starduststorm/motionhexa/case/motionhexa backcase v5-6 - 4.2mm button - 0.5-1mm clip.stl

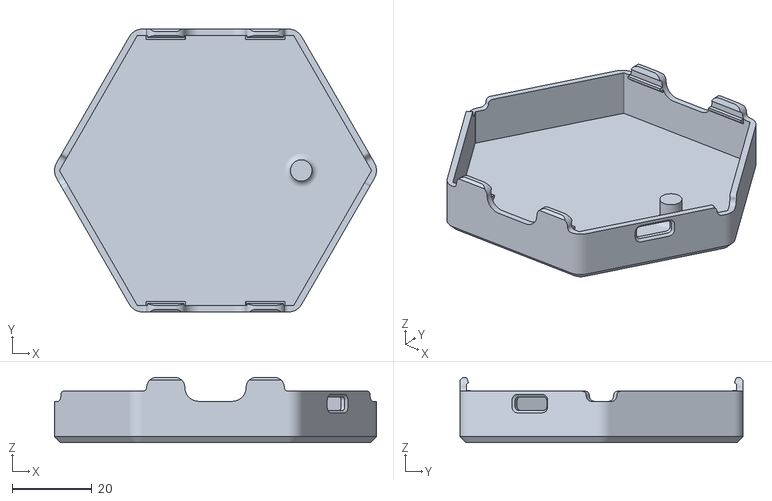
[picture p5: CAD file, 2026-09-29]
case/motionhexa backcase v5-6 - 4.2mm button - 0.5-1mm clip.stl
80.9 x 71.1 x 16.4
