starduststorm/motionhexa/case/motionhexa frontcase v7-8.stl

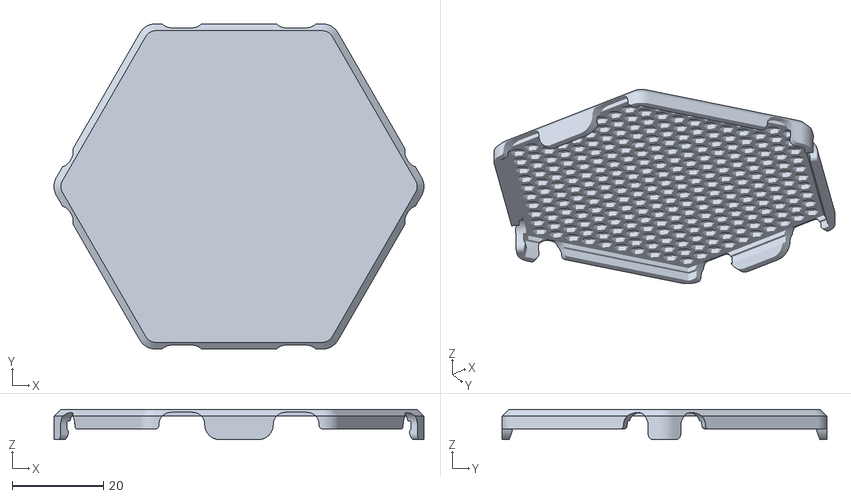
[picture p6: CAD file, 2026-09-29]
case/motionhexa frontcase v7-8.stl
80.9 x 71.1 x 6.64
