starduststorm/motionhexa/case/minihexa v2 - housing.stl

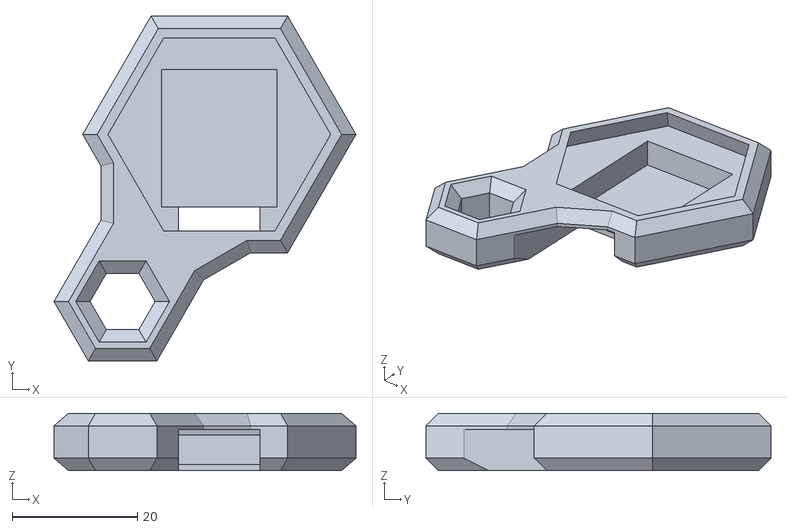
[picture p7: CAD file, 2026-09-29]
case/minihexa v2 - housing.stl
48.3 x 55.1 x 9.17
