starduststorm/motionhexa/case/motionhexa backcase v7-8 - 4.3mm button.stl

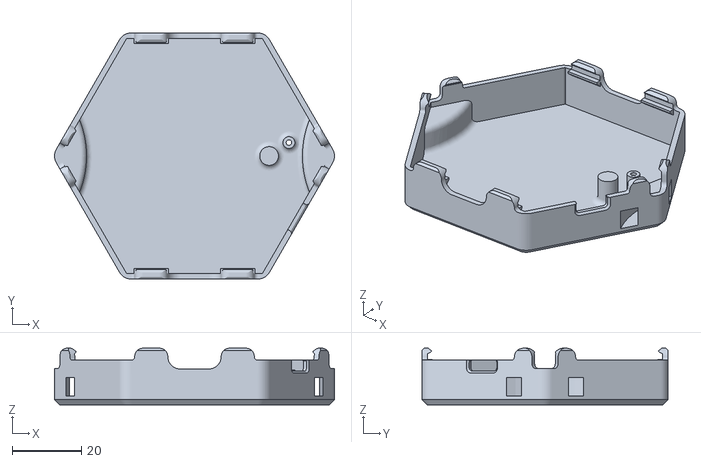
[picture p8: CAD file, 2026-09-29]
case/motionhexa backcase v7-8 - 4.3mm button.stl
80.9 x 71.1 x 16.4
