starduststorm/motionhexa/case/motionhexa frontcase v5-6.stl

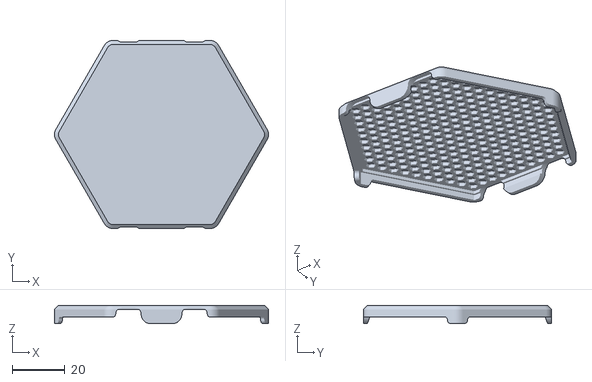
[picture p9: CAD file, 2026-09-29]
case/motionhexa frontcase v5-6.stl
80.9 x 71.1 x 6.84
