starduststorm/motionhexa/case/minihexa v2 - diffuser.stl

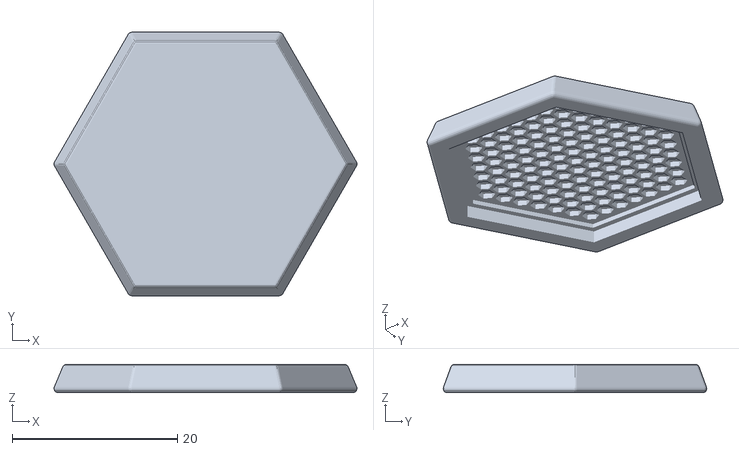
[picture p10: CAD file, 2026-09-29]
case/minihexa v2 - diffuser.stl
36.7 x 31.9 x 3.45
