starduststorm/motionhexa/doc/assets/hexa_v5_back_assembled.jpg

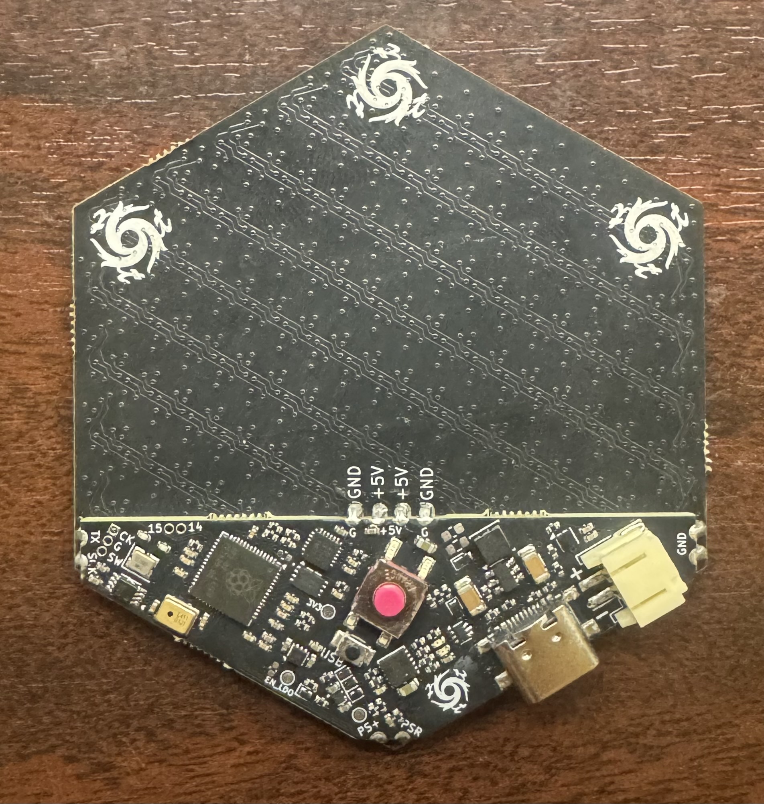
doc/assets/hexa_v5_back_assembled.jpg
