starduststorm/motionhexa/src/power.h

#ifndef POWER_H
#define POWER_H

#include <util.h>
#include <patterning.h>

#include "pinout.h"

const int kFullCharge = 95; // %, limit for charging ui
// The gauge's soc can't be relied on to reach kFullCharge (its capacity learning lags a new cell, and the charger quits at
// its own C/10 regardless), so the charge also counts as complete when the gauge says so (FC) or the charger has stopped
// pushing current into a cell that is near the top. 
const int16_t kChargeIdleMA = 50;
const uint16_t kChargeIdleMinMV = 4000; // below this, no current means a charger that isn't running, not one that finished
const unsigned long kChargeIdleHoldMS = 60000;
const uint16_t kGaugeFlagFullCharge = 1 << 9; // FLAGS FC, BQ27421 and BQ27427

// v5/v6 charger (LP28013HQVF-435) floats at 4.35V but the cells are 4.2V; v7's LY4176D terminates on its own.
#define SOFTWARE_CHARGE_LIMITER (HARDWARE_VERSION >= 5 && HARDWARE_VERSION < 7)

#if HARDWARE_VERSION >= 3
#include <BQ27427.h>
#endif
#if HARDWARE_VERSION >= 5
#include <tusb.h>
#include "hardware/structs/usb.h"
#endif
struct BatteryData {
  uint16_t stateOfCharge;   // %
  uint16_t stateOfHealth;   // %
  uint16_t voltage;         // mV
  uint16_t currentCapacity; // mAh
  uint16_t fullCapacity;    // mAh
  int16_t powerDraw;        // mW
  uint16_t temperature;     // K
  uint16_t flags;
  uint8_t softFull;         // ChargeController declared the battery full (software 4.2V cutoff); always 0 without SOFTWARE_CHARGE_LIMITER
  uint8_t thermalPaused;    // ThermalChargeGuard is holding the charger off because the board is too hot (v5+)
  uint8_t sampled;          // filled from a gauge read (vs. the zeroed initial value)
  uint16_t controlStatus;   // CONTROL_STATUS, for the log
  int16_t current;          // mA, average; positive = charging
  uint8_t presence;         // BatteryPresence result (v7+), see below
  void print(uint16_t senseMV = 0) {
    logf("battery: %s, soc: %u%%, soh: %u%%, voltage: %umV, sense: %umV, capacity: %umAh / %umAh, power: %imW, current: %imA, temp: %uK, flags: %X, status: %X%s%s%s",
      batteryDetected()?"yes":"no", stateOfCharge, stateOfHealth, voltage, senseMV, currentCapacity, fullCapacity, powerDraw, current, temperature, flags,
      controlStatus, gaugingReady() ? "" : ", initializing", softFull ? ", soft-full" : "", thermalPaused ? ", thermal-pause" : "");
  }
  enum : uint8_t { presenceUnknown = 0, presenceYes = 1, presenceNo = 2 };
  bool batteryDetected() {
#if HARDWARE_VERSION >= 7
    // v7: Can't use BAT_DET since it relies on the thermistor pin, so check the inferred result from BatteryPresence (core1)
    return presence == presenceYes;
#else
    // Issue: almost always detects a battery, presumably mistaking the lipo charger, powering the load, as a battery
    //   if the charger is off then the i2c reads will be all 1s, SoC will be 0xFFFF.
    //   but there is no battery we might still see a reasoanble "state of charge" because the lipo charger is tricking the BQ27*.
    return stateOfCharge <= 100 && flags & 1<<3;
#endif
  }
  // For a few seconds after a gauge reset, soc reads 0 with capacity 0/0. SoC is RemainingCapacity
  // over FullChargeCapacity, so FCC == 0 is exactly "no valid percentage yet" (and it comes good
  // ~2s before CONTROL_STATUS INITCOMP does).
  bool gaugingReady() {
    return sampled && fullCapacity != 0;
  }
  // A dead i2c bus reads all 1s (soc 65535%, 65535mV), which must never pass for a full battery.
  bool plausible() {
    return stateOfCharge <= 100 && voltage > 2000 && voltage < 4600;
  }
};
const unsigned int BATTERY_CAPACITY = 2000;
BatteryData batteryData = {0};

#if SOFTWARE_CHARGE_LIMITER
// BATTERY_SENSE (GPIO29/ADC3): BATSYS -20k- node -33k- GND
// Independent of the BQ27* gauge; useful to sanity-check its i2c voltage reading.
// Note: only call from core0 — the photosensor also muxes the (single) ADC from core0.
uint16_t batterySenseMV() {
  const uint32_t kSenseTopR = 20000, kSenseBottomR = 33000;
  uint32_t nodeMV = analogRead(BATTERY_VOLTAGE_PIN) * 3300ul / 1023;
  return nodeMV * (kSenseTopR + kSenseBottomR) / kSenseBottomR;
}
// core0 samples the sense pin here so core1's battery log can print it next to the gauge voltage
volatile uint16_t lastBatterySenseMV = 0;
#endif // SOFTWARE_CHARGE_LIMITER

class PowerManager {
  bool runningState = 0;
  unsigned long lastRunningChange=0;  // ms
  bool chargingState = 0;
  unsigned long lastChargingChange=0; // ms
  int knownChargePercent = 0;
  unsigned long lastFullChargeChange=0; // ms
  unsigned long chargeIdleSince = 0;    // ms, 0 when the charger is (or may be) still pushing current

  void setCharging(bool charging) {
    if (chargingState != charging) {
      logf("Charging State Change %i -> %i, (battery:%i) since lastReachedFullCharge = %i", 
            chargingState, charging, batteryData.batteryDetected(), millis() - lastReachedFullCharge());
      chargingState = charging;
      lastChargingChange = millis();
    }
  }
public:
  bool batteryInitialized = false;
  
  // "running" means logical on-state, drawing design patterns, rather than drawing charging ui or powered on but not drawing.
  bool isRunning() {
    return runningState;
  }
  void setRunning(bool running) {
    runningState = running;
    lastRunningChange = millis();
  }
  unsigned long lastRunStateChange() {
    return lastRunningChange;
  }
  bool isCharging() { // usb powered and has a battery attached, even if fully charged
    return chargingState;
  }
  unsigned long lastChargingStateChange() {
    return lastChargingChange;
  }
  unsigned long lastReachedFullCharge() { // 0 if not "fully charged" to kFullCharge
    return lastFullChargeChange;
  }
  void update(bool vbusPowered, BatteryData &batteryData) {
    // The charging ui opens on the edge of lastChargingStateChange(), so don't declare charging
    // until the gauge is readable or the edge fires seconds before there's anything to draw.
    // Unplugged is unambiguous without the gauge.
    if (!vbusPowered) {
      setCharging(false);
    } else if (batteryData.gaugingReady()) {
      setCharging(batteryInitialized && batteryData.batteryDetected());
    }
    if (!batteryData.gaugingReady() || !batteryData.plausible()) {
      return;
    }

    bool chargeIdle = vbusPowered && !batteryData.thermalPaused && batteryData.voltage >= kChargeIdleMinMV && batteryData.current < kChargeIdleMA;
    if (!chargeIdle) {
      chargeIdleSince = 0;
    } else if (chargeIdleSince == 0) {
      chargeIdleSince = millis();
    }
    bool chargerDone = chargeIdleSince != 0 && millis() - chargeIdleSince >= kChargeIdleHoldMS;
    bool gaugeFull = vbusPowered && (batteryData.flags & kGaugeFlagFullCharge);

    // ChargeController's software cutoff is authoritative for "full"
    int chargePercent = (batteryData.softFull || chargerDone || gaugeFull) ? 100 : batteryData.stateOfCharge;
    if (chargePercent >= kFullCharge && knownChargePercent < kFullCharge) {
      logdf("Reached Full Charge!");
      lastFullChargeChange = millis();
    } else if (chargePercent < kFullCharge-3) {
      lastFullChargeChange = 0;
    }
    knownChargePercent = chargePercent;
  }
};
PowerManager powerState;

// Raw CHEM_ID readback values (not the same as the CHEM_A/B/C subcommand enum):
// BQ27427: 0x3230 = 4.35V (default), 0x1202 = 4.2V, 0x3142 = 4.4V
// BQ27421 chemistry is fixed per hardware variant instead (YZFR-G1A = 4.2V) and reads 0x0128.
const uint16_t kBQ27421DeviceType = 0x421;
const uint16_t kBQ27427DeviceType = 0x427;
const uint16_t kBQ27427ChemID4V2 = 0x1202;
// CC Gain sign bit (CC Cal[5] bit 7, via BQ27427::currentPolarity()) that makes charge current read positive on
// our wiring. The ROM default (1) is the other one; see initializeBattery().
const bool kBQ27427ChargePositivePolarity = false;

// "BATRESET" serial command: full gauge reset + reconfigure, to shed learned state (FCC/Qmax).
// Parsed on core0; executed on core1, which owns i2c.
const char* kBatteryResetCommand = "BATRESET";
volatile bool batteryResetRequested = false;

// Gauge config versioning: the Design Capacity we program doubles as a config-generation marker.
// Versioning lasts while BQ2742* is powered, mismatch triggers a reset+reconfigure.
// Bump the generation whenever the config values in initializeBattery() change.
// Older firmware wrote a plain 2000 (at the wrong offset on the BQ27421); ROM default is 1340.
const uint16_t kGaugeConfigGeneration = 3; // 2: BQ27427 current polarity, 3: BQ27427 SLEEP disabled
uint16_t targetDesignCapacity() { return BATTERY_CAPACITY + kGaugeConfigGeneration; }

// Reads the marker without disturbing the gauge. Returns 0 on error.
// A normal-mode data memory block read (no config-update round trip, no soft reset), validated
// against a byte we never write with a known ROM default (State offset 5, Load Select/Mode = 0x81).
// The BQ27421 also has a DesignCapacity() command (0x3C) as a fallback; the BQ27427 doesn't.
#if HARDWARE_VERSION >= 5
const uint8_t kStateLoadSelectOffset = 5;
const uint8_t kStateLoadSelectDefault = 0x81;
uint16_t readGaugeDesignCapacity(uint16_t deviceType) {
  uint8_t loadSel = 0;
  bool peekOK = lipo.peekDataMemory(BQ27427_ID_STATE, kStateLoadSelectOffset, &loadSel, 1)
             && loadSel == kStateLoadSelectDefault;
  uint16_t peeked = peekOK ? lipo.peekDataMemoryWord(BQ27427_ID_STATE, lipo.designCapacityOffset()) : 0;
  uint16_t direct = 0;
  if (deviceType == kBQ27421DeviceType) {
    Wire.beginTransmission(BQ27427_I2C_ADDRESS);
    Wire.write(0x3C);
    if (Wire.endTransmission(true) == 0 && Wire.requestFrom((uint8_t)BQ27427_I2C_ADDRESS, (uint8_t)2) == 2) {
      uint16_t lsb = Wire.read();
      direct = (uint16_t)(Wire.read() << 8) | lsb;
    }
  }
  btlogf("[t=%lu] gauge marker: data memory %s (load select %02X) reads %u; 0x3C reads %u",
         millis(), peekOK ? "valid" : "INVALID", loadSel, peeked, direct);
  return peekOK ? peeked : direct;
}
#endif

// Configures the gauge on the first battery connection (ITPOR) or a config-generation change;
// otherwise a few reads confirm the marker and the running gauge is left alone. The config path
// blocks core1 for ~1.5s (mostly the gauge's soft reset on exitConfig), so should be a rare init path.
volatile uint16_t gaugeDeviceTypeRead = 0; // last DEVICE_TYPE the gauge answered with (0xFFFF/0 = no answer), for HWTEST
bool initializeBattery() {
  bool success = false;
#if HARDWARE_VERSION >= 5
  uint16_t deviceType = lipo.deviceType();
  gaugeDeviceTypeRead = deviceType;
  logdf("coulomb counter deviceType = %X", deviceType);

  if (deviceType != kBQ27421DeviceType && deviceType != kBQ27427DeviceType) {
    // An absent gauge reads all 1s, which passes every flag test below and then spins
    // enterConfig/exitConfig for their full 2s timeouts each.
    logdf("no coulomb counter (deviceType = %X); skipping gauge config", deviceType);
    return false;
  }
  lipo.setDeviceType(deviceType); // BQ27421 (v5/v6) and BQ27427 (v7) lay out data memory differently

  bool itpor = lipo.itporFlag();
  btlogf("[t=%lu] initializeBattery: deviceType=%X itpor=%i", millis(), deviceType, itpor);
  if (!itpor) {
    uint16_t designCapacity = readGaugeDesignCapacity(deviceType);
    if (designCapacity == targetDesignCapacity()) {
      btlogf("[t=%lu] initializeBattery: fast path, gauge already at generation %u", millis(), kGaugeConfigGeneration);
      return true;
    }
    if (designCapacity == 0) {
      btlogf("[t=%lu] initializeBattery: design capacity read failed, deferring", millis());
      return true;
    }
    // Configured by older firmware: full reset to shed its learned state, then reconfigure
    // (reset sets ITPOR). Once per boot, so a failing config write can't reset-loop.
    static bool didMigrationReset = false;
    if (didMigrationReset) return true;
    didMigrationReset = true;
    logf("gauge config generation mismatch (design capacity %u, want %u): resetting gauge state",
         designCapacity, targetDesignCapacity());
    if (!lipo.reset()) return false;
    delay(100); // let the gauge finish re-initializing
  }

  unsigned long configStart = millis();
  // always logged: this path costs the gauge its learned state, so the boot log should say why it was taken
  logf("gauge: full config path (itpor %i, flags %04X, status %04X, chem %04X)", itpor, lipo.flags(), lipo.status(), (uint16_t)lipo.chemID());

  // BQ27427 defaults to the 4.35V chem profile; our cells are 4.2V.
  if (deviceType == kBQ27427DeviceType && (uint16_t)lipo.chemID() != kBQ27427ChemID4V2) {
    bool chemSuccess = lipo.setChemID(CHEM_B);
    btlogf("[t=%lu] initializeBattery: setChemID(CHEM_B) = %i", millis(), chemSuccess);
  }

  success = lipo.enterConfig(true);
  success &= lipo.setCapacity(targetDesignCapacity()); // BATTERY_CAPACITY + config-generation marker
  success &= lipo.setDesignEnergy(BATTERY_CAPACITY * 3.7f); // mWh, nominal 3.7V cell
  success &= lipo.setTerminateVoltage(3200); // mV; loaded voltage where SoC=0
  // Taper Rate = Design Capacity / (0.1 * taper current), taper current = 100mA:
  success &= lipo.setTaperRate(10 * BATTERY_CAPACITY / 100);
  if (deviceType == kBQ27427DeviceType) {
    // The BQ27427 ships with the wrong CC Gain sign (TI E2E #1350114; not in the datasheet).
    // Flip it so charge is positive, as the BQ27421 on v5/v6 reads and BatteryData::current documents.
    // The coulomb counter follows the same sign (RemainingCapacity climbs on charge after the flip).
    bool polarity = lipo.currentPolarity();
    bool polaritySuccess = polarity == kBQ27427ChargePositivePolarity || lipo.changeCurrentPolarity();
    logf("gauge: BQ27427 current polarity bit %i (want %i)%s", polarity, kBQ27427ChargePositivePolarity,
         polaritySuccess ? "" : " - write FAILED");
    success &= polaritySuccess;
  }
  if (deviceType == kBQ27427DeviceType) {
    // v7 pulls GPOUT up to the gauge's own 1.8V regulator output (R6, 10k), and GPOUT runs to an RP2350 pin. Whenever that
    // pin isn't high-Z (pad pull-down during reset/BOOTSEL, its protection diode with +3V3 off) R6 loads the regulator,
    // and a gauge in SLEEP power-on-resets under it: ROM defaults, learned state gone, SoC re-guessed from OCV at every
    // power-on. Bench 2026-09-19 (scripts/swd/gauge_reset/): driving GPOUT low reset 3 of 3 sleeping gauges within seconds
    // and never an awake one. So don't let it sleep (~50uA instead of ~9uA); the real fix is R6 to +3V3 or unpopulated.
    uint16_t opConfigBefore = lipo.operationConfig();
    bool sleepSuccess = lipo.setSleepEnabled(false);
    logf("gauge: SLEEP disabled = %i (OpConfig %04X -> %04X)", sleepSuccess, opConfigBefore, lipo.operationConfig());
    success &= sleepSuccess;
  }
  delay(5); // Hack: I don't know why a delay is required here but exitConfig fails without this
  success &= lipo.exitConfig(true); // soft reset: gauge re-inits from a fresh OCV estimate
  btlogf("[t=%lu] initializeBattery: full config path done, success=%i, took %lums, marker reads %u (want %u)",
         millis(), success, millis() - configStart, readGaugeDesignCapacity(deviceType), targetDesignCapacity());
#endif
  return success;
}

#if SOFTWARE_CHARGE_LIMITER
/* Software 4.2V charge cutoff
 * v4-v6 has uses a LP28013HQVF-435 for charging, which charges to 4.35V, but our cells are 4.2V lipo.
 * termination IBF = RISET*IBAT/RIBF = 1.8k*1A/20k = 90mA, but this only applies after 4.35V float.
 * We'll use ~EN_CHARGE to disable the charger after reading 4.2V+, wait for cell relax, 
 * and mark it as soft-full when it remains near cutoff.
*/
/* Pacing: the pack has enough series resistance (~0.5ohm incl. cell ESR) that the moment the
 * charger enables, the measured terminal voltage jumps to the charger's 4.35V CV point even
 * with the cell nowhere near full — so the on-charge voltage is IR, not cell state, and is
 * useless as a cutoff signal. Instead, all decisions use the relaxed voltage (charger off,
 * settles in <5s), and charge runs in timed ON pulses whose duration shrinks
 * as the relaxed voltage approaches full. 
 */
const uint16_t kChargeFullMV    = 4150; // relaxed voltage at/above this => full
const uint16_t kRechargeMV      = 4050; // after full, start a new charge cycle below this
const unsigned long kChargeSettleMS = 5000; // relaxation time after an ON pulse before judging voltage

// ON-pulse duration from the last relaxed voltage: lenient in bulk, cautious near the top.
// Sized so a pulse can't skip past full: even 120s at 1A is ~33mAh (~1.7% SoC, a few tens
// of mV of OCV), and each pulse ends with a relaxed-voltage check.
unsigned long chargePulseMS(uint16_t relaxedMV) {
  if (relaxedMV < 4000) return 120000; // bulk: cell well below full
  if (relaxedMV < 4100) return 30000;
  return 10000;                        // approaching kChargeFullMV; charger current is tapered here anyway
}

// total pack series resistance (cell ESR + protection + leads + traces), from bench logs:
// ~500mV of relaxation at ~1A. used to un-sag loaded off-phase readings; bench-tune.
const uint16_t kPackResistanceMilliOhm = 500;

class ChargeController {
public:
  enum State : uint8_t { charging, settling, full };
private:
  State state = settling; // measure the relaxed voltage before the first pulse
  unsigned long stateEnteredAt = 0;
  uint16_t relaxedMV = 0; // last settled charger-off voltage (sags with system load; thresholds account for it)
  bool chargeEnabled = false; // setup() boots with the charger disabled

  void enterState(State newState) {
    state = newState;
    stateEnteredAt = millis();
  }
  void setChargeEnabled(bool enable, uint16_t mv) {
    if (enable != chargeEnabled) {
      chargeEnabled = enable;
      digitalWrite(DISABLE_CHARGE_PIN, !enable); // ~EN_CHARGE: high disables the charger
      logdf("charger %s (state=%u, %umV, relaxed %umV)", enable ? "enabled" : "disabled", state, mv, relaxedMV);
    }
  }
  static bool plausibleVoltage(uint16_t mv) {
    return mv > 2500 && mv < 4450; // filters 0 / 0xFFFF from failed i2c reads
  }
  // The charger is off in settling/full, so any measured power draw is system load sagging
  // the reading; estimate the unloaded OCV so pattern load while plugged can't hide a full
  // cell. Only ever raises the value => errs toward stopping charge early, the safe direction.
  static uint16_t estimatedRelaxedMV(BatteryData &bd) {
    uint32_t loadSagMV = (uint32_t)abs(bd.powerDraw) * kPackResistanceMilliOhm / bd.voltage;
    return bd.voltage + loadSagMV;
  }
public:
  bool isChargeEnabled() { return chargeEnabled; }
  bool isFull() { return state == full; }

  // Called from the core1 battery poll with fresh gauge data. thermalPause (ThermalChargeGuard) holds the charger off.
  void update(BatteryData &bd, bool thermalPause) {
    if (!bd.batteryDetected() || !plausibleVoltage(bd.voltage)) {
      // No battery, or we can't read the gauge: don't charge what we can't supervise.
      setChargeEnabled(false, bd.voltage);
      enterState(settling); // re-measure before charging if readings return
      bd.softFull = false;
      return;
    }
    if (thermalPause) {
      // Too hot to charge
      setChargeEnabled(false, bd.voltage);
      if (state == charging) enterState(settling);
      bd.softFull = (state == full);
      return;
    }
    switch (state) {
      case charging:
        // timed pulse; on-charge voltage itself is ignored (it reads ~4.35V regardless)
        if (millis() - stateEnteredAt >= chargePulseMS(relaxedMV)) {
          enterState(settling);
        }
        break;
      case settling:
        if (millis() - stateEnteredAt < kChargeSettleMS) break; // let the cell relax first
        relaxedMV = estimatedRelaxedMV(bd);
        enterState(relaxedMV >= kChargeFullMV ? full : charging);
        break;
      case full:
        // No power path: plugged-in system load drains the battery until we top it back off.
        if (estimatedRelaxedMV(bd) < kRechargeMV) {
          relaxedMV = estimatedRelaxedMV(bd);
          enterState(charging);
        }
        break;
    }
    setChargeEnabled(state == charging, bd.voltage);
    bd.softFull = (state == full);
  }
};
ChargeController chargeController;
#endif // SOFTWARE_CHARGE_LIMITER

#if HARDWARE_VERSION >= 5
// Thermal charge pause - v7s seen charging at up to 70ºC which is too hot for PLA front case.
const int16_t kChargePauseC = 60;
const int16_t kChargeResumeC = 55;
const unsigned long kChargePauseMinMS = 60000; // once paused stay off at least this long: the gauge is coarse and slow

// "CHGPAUSE 0|1|AUTO" serial command: force the charger on/off or return to the thermal guard.
volatile int8_t chargePauseOverride = -1;

class ThermalChargeGuard {
  bool paused = false;
  unsigned long pausedAt = 0;
public:
  bool isPaused() const { return paused; }
  // Called from the core1 battery poll with each gauge sample (also failed ones: those hold the last decision).
  // Returns whether the charger should be held off, and publishes that in bd for core0.
  bool update(BatteryData &bd) {
    bool valid = bd.sampled && bd.plausible() && bd.temperature != 0;
    if (chargePauseOverride >= 0) {
      paused = chargePauseOverride != 0;
    } else if (valid && !bd.batteryDetected()) {
      // nothing to heat; and on v7 the charger output is what's powering us
      paused = false;
    } else if (valid) {
      int tempC = (int)bd.temperature - 273;
      if (!paused && tempC >= kChargePauseC) {
        paused = true;
        pausedAt = millis();
        logf("[t=%lu] thermal charge pause: gauge %iC >= %iC (%umV, %imA)", millis(), tempC, kChargePauseC, bd.voltage, bd.current);
      } else if (paused && tempC <= kChargeResumeC && millis() - pausedAt >= kChargePauseMinMS) {
        paused = false;
        logf("[t=%lu] thermal charge resume: gauge %iC <= %iC after %lus (%umV)", millis(), tempC, kChargeResumeC, (millis() - pausedAt) / 1000, bd.voltage);
      }
    }
    bd.thermalPaused = paused;
    return paused;
  }
};
ThermalChargeGuard thermalChargeGuard;
#endif // HARDWARE_VERSION >= 5

#if HARDWARE_VERSION >= 7
// EN_CHARGE is pulled up to enable the LY4176D. Release it to enable and sink it to disable, so we never drive
// against the pull-up rail.
void setChargerEnabled(bool enable) {
  static int8_t current = -1;
  if (current == (int8_t)enable) return;
  current = enable;
  if (enable) {
    pinMode(EN_CHARGE, INPUT);
  } else {
    pinMode(EN_CHARGE, OUTPUT);
    digitalWrite(EN_CHARGE, LOW);
  }
  logf("charger %s (EN_CHARGE %s)", enable ? "enabled" : "disabled", enable ? "released" : "sunk");
}
#endif

#if HARDWARE_VERSION >= 7
// Infers whether a cell is actually connected, since the gauge can't tell us (see BatteryData::batteryDetected).
// Evidence, evaluated on each 5s gauge sample while VBUS is present (unplugged and running implies a cell):
//   no cell:  voltage above anything a 4.2V-terminated cell can reach (the LY4176D output floats to ~4.3-4.6V unloaded),
//             or the reading jumping between samples (measured 4327 -> 4549mV sample to sample with no cell; a cell under
//             our <1A load moves a few tens of mV at most, ~50mV for a full pixel-load step at ~100mOhm pack).
//   cell:     voltage in the cell range and steady between samples.
// Two consecutive agreeing votes flip the result; a single ambiguous or contradicting sample holds it. A first sample that
// is unambiguous decides immediately so the charging ui isn't delayed by a whole poll interval.
class BatteryPresence {
  static const uint16_t kNoCellMV = 4270;      // above the 4.2V termination + margin
  static const uint16_t kCellMaxMV = 4230;     // steady readings up to here are a cell on charge
  static const uint16_t kCellMinMV = 2800;
  static const uint16_t kJitterNoCellMV = 120; // sample-to-sample swing that no cell produces
  static const uint16_t kJitterCellMV = 60;    // sample-to-sample swing consistent with a cell
  uint16_t lastVoltage = 0;
  uint8_t result = BatteryData::presenceUnknown;
  uint8_t pendingResult = BatteryData::presenceUnknown;
  uint8_t pendingVotes = 0;

  void vote(uint8_t v) {
    if (v == BatteryData::presenceUnknown) { pendingVotes = 0; return; }
    if (v == result) { pendingVotes = 0; return; }
    if (v == pendingResult) {
      pendingVotes++;
    } else {
      pendingResult = v;
      pendingVotes = 1;
    }
    // first decision is immediate, later flips need agreement
    if (result == BatteryData::presenceUnknown || pendingVotes >= 2) {
      logf("battery presence: %s (voltage %umV, current %imA)", v == BatteryData::presenceYes ? "cell detected" : "no cell", lastVoltage, lastCurrent);
      result = v;
      pendingVotes = 0;
    }
  }
  int16_t lastCurrent = 0;
public:
  uint8_t current() { return result; }
  // returns the result after folding in this sample
  uint8_t update(const BatteryData &bd, bool vbusPowered) {
    lastCurrent = bd.current;
    if (!vbusPowered) {
      // nothing but a cell can be powering us
      lastVoltage = bd.voltage;
      vote(BatteryData::presenceYes);
      return result;
    }
    if (bd.voltage == 0 || bd.voltage == 0xFFFF) {
      // failed read, no information
      return result;
    }
    uint16_t jitter = lastVoltage ? (uint16_t)abs((int)bd.voltage - (int)lastVoltage) : 0;
    bool haveHistory = lastVoltage != 0;
    lastVoltage = bd.voltage;

    if (bd.voltage > kNoCellMV || (haveHistory && jitter > kJitterNoCellMV)) {
      vote(BatteryData::presenceNo);
    } else if (bd.voltage >= kCellMinMV && bd.voltage <= kCellMaxMV && (!haveHistory || jitter <= kJitterCellMV)) {
      vote(BatteryData::presenceYes);
    } else {
      vote(BatteryData::presenceUnknown); // 4230..4270mV band, or a mid-size swing: wait for the next sample
    }
    return result;
  }
};
BatteryPresence batteryPresence;
#endif

#if HARDWARE_VERSION >= 5
// VBUS_PRESENCE plausibility filter confirmed on v7
// After USB is unplugged the VBUS node does not bleed off through the 20k/33k sense divider: TinyUSB forces the
// VBUS-detect override, so the RP2040/RP2350 keeps its 1.5k D+ pull-up on, and D+ back-feeds the VBUS node through the
// USBLC6's clamp diode (its VBUS pin is on the VBUS net). The node parks at ~2.6-2.8V, which lands VBUS_PRESENCE right at
// the input threshold: the pin can read "powered" for seconds to minutes after unplug. Clearing PULLUP_EN dropped the node
// to ~1.5V within a second on the bench, so: while no host is talking (a charger never does), keep the pull-up down and only
// re-assert it briefly every few seconds so a host that is plugged in can still find us. With the pull-up down the node is
// not back-fed and the pin is honest; while it is up, hold the last honest answer. Unplug is then seen within ~1.6s.
// "Talking" is judged from the hardware SOF counter rather than tud_suspended(), which TinyUSB only reports for a link that
// was once enumerated.
struct VbusSense {
  static constexpr uint32_t kHostQuietMS = 1000;        // no SOFs for this long = nobody is talking to us
  static constexpr uint32_t kBleedMS = 600;             // pull-up off this long before the pin is trusted
  static constexpr uint32_t kProbeOnMS = 1000;          // pull-up re-asserted this long so a host can still enumerate us...
  static constexpr uint32_t kProbePeriodFastMS = 4000;  // ...every this often when no host ever enumerated us (charger, nothing)
  static constexpr uint32_t kProbePeriodSlowMS = 20000; // ...when an enumerated host went quiet (asleep): don't keep poking it
  uint32_t lastSof = 0, lastSofChange = 0;
  uint32_t pullupSince = 0;   // millis of the last pull-up state change
  bool pullupOn = true;       // TinyUSB connects at boot
  bool inited = false;
  bool lastTrusted = false;   // last pin reading taken with the pull-up off (or with a host talking)

  void setPullup(bool on, uint32_t now) {
    if (on) tud_connect(); else tud_disconnect();
    pullupOn = on; pullupSince = now;
  }

  bool update(bool rawPin) {
    uint32_t now = millis();
    uint32_t sof = usb_hw->sof_rd & 0x7ff;
    if (sof != lastSof) { lastSof = sof; lastSofChange = now; }
    if (!inited) { inited = true; lastTrusted = rawPin; pullupSince = now; }

    if (now - lastSofChange < kHostQuietMS) {
      // a host is talking: VBUS is really there and we must keep the pull-up up
      if (!pullupOn) setPullup(true, now);
      lastTrusted = rawPin;
      return rawPin;
    }
    if (pullupOn) {
      // quiet with the pull-up up: the node may be back-fed, so don't trust the pin. drop the pull-up once the probe
      // window is over (immediately on the talking->quiet edge, since pullupSince is then long past)
      if (now - pullupSince >= kProbeOnMS) setPullup(false, now);
      return lastTrusted;
    }
    // pull-up down: nothing back-feeds the node, so once it has bled the pin is honest
    if (now - pullupSince >= kBleedMS) {
      if (rawPin != lastTrusted) logf("VBUS_PRESENCE (verified) -> %i", rawPin);
      lastTrusted = rawPin;
    }
    uint32_t period = tud_connected() ? kProbePeriodSlowMS : kProbePeriodFastMS;
    if (now - pullupSince >= period) setPullup(true, now);
    return lastTrusted;
  }
};
VbusSense vbusSense;
#endif

#if HARDWARE_VERSION >= 7
// Intentional low-battery shutdown at 3.3V rather than waiting for system failure
// since on the v7s it tends to result in glitches rather than plain shutoff like the v6s.
const uint16_t kLowBatteryShutdownMV = 3200;
const uint16_t kLowBatteryStartMV = 3300;
// Wait ms for first power status sample before drawing boot animation
const unsigned long kLowBatteryStartWaitMS = 150;
const uint16_t kLowBatteryWatchMV = 3500;
const unsigned long kLowBatteryPollMS = 1000;
const unsigned long kLowBatteryShutdownHoldMS = 5000; // continuously below for this long (3 fast polls), so one load-step sample can't trip it

class LowBatteryMonitor {
  unsigned long belowSince = 0;
  bool startChecked = false;
public:
  enum Result : uint8_t { ok, refuseStart, shutdown };
  static bool plausibleVoltage(uint16_t mv) {
    return mv > 2000 && mv < 4600; // filters 0 / 0xFFFF from failed i2c reads
  }
  // Whether the power-on check has had its say, so main can hold the power-on animation until it's known to be wanted
  bool startResolved(bool vbusPowered) {
    return startChecked || vbusPowered || millis() > kLowBatteryStartWaitMS;
  }
  // refuseStart: the first gauge sample after boot found the cell too flat to start from (reported once)
  // shutdown: the cell has sat under the shutdown voltage for the hold time while running from it
  Result update(bool vbusPowered, BatteryData &bd) {
    if (!bd.gaugingReady() || !plausibleVoltage(bd.voltage)) {
      belowSince = 0;
      return ok;
    }
    bool firstSample = !startChecked;
    if (firstSample) {
      logf("[t=%lu] low battery start check: %umV%s", millis(), bd.voltage, vbusPowered ? " (on VBUS)" : "");
    }
    startChecked = true;
    if (vbusPowered) {
      belowSince = 0;
      return ok;
    }
    if (firstSample && bd.voltage < kLowBatteryStartMV) {
      logf("low battery: %umV at power-on, under %umV", bd.voltage, kLowBatteryStartMV);
      return refuseStart;
    }
    if (bd.voltage >= kLowBatteryShutdownMV) {
      belowSince = 0;
      return ok;
    }
    if (belowSince == 0) {
      belowSince = millis();
      logf("low battery: %umV, under %umV", bd.voltage, kLowBatteryShutdownMV);
    }
    return millis() - belowSince >= kLowBatteryShutdownHoldMS ? shutdown : ok;
  }
};
LowBatteryMonitor lowBattery;

class LowBatteryIndicator : public Pattern {
  static const int ringRadius = 2;
  const unsigned long pulseDuration = 450;
  const int pulseCount = 2;
public:
  void update() {
    ctx.leds.fill_solid(CRGB::Black);
    unsigned long t = runTime();
    if (t >= pulseCount * pulseDuration) {
      stop();
      return;
    }
    CRGB color = CHSV(0, 0xFF, ease8InOutQuad(triwave8(0xFF * (t % pulseDuration) / pulseDuration)));
    color.nscale8(0x7F);
    // walk the ring: one spoke of ringRadius steps, rotated onto each of the six sides
    Axial center = axial.axialFromPixelIndex(kHexaCenterIndex);
    for (int step = 0; step < ringRadius; ++step) {
      Axial ax(ringRadius - step, step); // from the +q corner toward the +r corner; s = -ringRadius throughout
      for (int side = 0; side < 6; ++side) {
        auto pxOpt = axial.indexAtAxial(center.q() + ax.q(), center.r() + ax.r());
        if (pxOpt) {
          ctx.leds[pxOpt.value()] = color;
        }
        // rotate to next side
        ax = Axial(-ax.r(), -ax.s());
      }
    }
  }
  const char *description() {
    return "LowBatteryIndicator";
  }
};
#endif

bool sampleBattery(BatteryData &out) {
  assert(1 == get_core_num(), "sampleBattery not on core1");
#if HARDWARE_VERSION >= 5
  // TODO: fetch only the data items we'll actually use, for perf
  BatteryData bd = {0};
  bd.stateOfCharge = lipo.soc(FILTERED);
  bd.voltage = lipo.voltage();
  if (!bd.plausible()) {
    // failed reads (seen on v7: SDA held low for minutes mid-charge), don't block core1
    return false;
  }
  bd.stateOfHealth = lipo.soh(PERCENT);
  bd.currentCapacity = lipo.capacity(REMAIN);
  bd.fullCapacity = lipo.capacity(FULL);
  bd.powerDraw = lipo.power();
  bd.current = lipo.current(AVG);
  bd.temperature = lipo.temperature(INTERNAL_TEMP)/10.;
  bd.flags = lipo.flags();
  bd.controlStatus = lipo.status();
  bd.sampled = true;
#if HARDWARE_VERSION >= 7
  bd.presence = batteryPresence.update(bd, digitalRead(VBUS_SENSOR_PIN));
#endif
  out = bd;
  return true;
#else
  return false;
#endif
}

#if HARDWARE_VERSION >= 5
#if DEBUG_BOOT_TIMING
// Times a blocking step on core1 and reports it if it ate more than a few motion frames.
#define CORE1_STEP(label, ...) do { \
    unsigned long _stepStart = millis(); \
    __VA_ARGS__; \
    unsigned long _stepMS = millis() - _stepStart; \
    if (_stepMS >= kStallLogMS) logf("[t=%lu] core1 stall: %s blocked %lums", millis(), label, _stepMS); \
  } while (0)
#else
#define CORE1_STEP(label, ...) do { __VA_ARGS__; } while (0)
#endif

// Motion is the QoS-critical stream on core1, so gauge i2c is one bounded step per motion frame,
// starting only once motion frames are flowing. Returns true when `bd` holds a fresh sample.
// `motionStartedAt` is when core1 began publishing motion frames.
const unsigned long kBatteryStartDelayMS = 100;
bool battery_step_core1(unsigned long motionStartedAt, BatteryData &bd) {
  assert(1 == get_core_num(), "battery_step_core1 not on core1");
  static bool batterySucess = false;
  static bool didInitialize = false;
  static unsigned long lastBatteryPoll = 0;

  if (millis() - motionStartedAt < kBatteryStartDelayMS) {
    return false;
  }
  if (!didInitialize) {
    // Normally a few reads; the gauge stays up on battery across power cycles, so it already
    // holds our config and a valid soc for the first sample.
    didInitialize = true;
    CORE1_STEP("initializeBattery", batterySucess = initializeBattery());
    powerState.batteryInitialized = batterySucess; // should be fine to write this bool from core1?
    logf("initializeBattery = %i", batterySucess);
    return false;
  }
  if (batteryResetRequested) {
    batteryResetRequested = false;
    // CONTROL_RESET reloads ROM defaults and sets ITPOR, so initializeBattery() takes its config path.
    bool resetOK = false;
    CORE1_STEP("BATRESET lipo.reset", resetOK = lipo.reset());
    delay(100); // let the gauge finish re-initializing before reconfiguring it
    CORE1_STEP("BATRESET initializeBattery", batterySucess = initializeBattery());
    powerState.batteryInitialized = batterySucess;
    logf("BATRESET: reset=%i reconfigure=%i", resetOK, batterySucess);
    lastBatteryPoll = 0; // poll fresh gauge data immediately
    return false;
  }
#if SOFTWARE_CHARGE_LIMITER
  // fast polls whenever supervising an active charge cycle: pulse timing and settle
  // sampling both want ~1s resolution. slow polls when unplugged or battery full.
  unsigned long batteryPollInterval = (digitalRead(VBUS_SENSOR_PIN) && !chargeController.isFull()) ? 1000 : 5000;
#else
  // charger terminates on its own; polls feed soc/ui, and LowBatteryMonitor once the cell is nearly flat
  static uint16_t lastPolledMV = 0;
  bool watchingLowBattery = lastPolledMV != 0 && lastPolledMV < kLowBatteryWatchMV && !digitalRead(VBUS_SENSOR_PIN);
  const unsigned long batteryPollInterval = watchingLowBattery ? kLowBatteryPollMS : 5000;
#endif
  if (lastBatteryPoll != 0 && millis() - lastBatteryPoll < batteryPollInterval) {
    return false;
  }
  if (!batterySucess) {
    // retry if we had a transient i2c failure at boot
    CORE1_STEP("initializeBattery retry", batterySucess = initializeBattery());
    powerState.batteryInitialized = batterySucess;
    if (batterySucess) {
      logf("initializeBattery retry succeeded");
      return false; // start sampling next frame rather than stacking i2c into this one
    }
    lastBatteryPoll = millis();
    // No readable gauge: publish an empty sample, which batteryDetected() reads as no battery.
    bd = {0};
    bd.sampled = true;
    return true;
  }
  bool sampled = false;
  CORE1_STEP("sampleBattery", sampled = sampleBattery(bd));
  lastBatteryPoll = millis();
  static uint16_t failedSamples = 0;
  if (!sampled) {
    // detect failures and publish empthy samples
    const uint16_t kFailedSamplesBeforeUnknown = 3;
    failedSamples++;
#if SOFTWARE_CHARGE_LIMITER
    chargeController.update(bd, thermalChargeGuard.update(bd)); // implausible voltage: stops the charge it can no longer supervise
#endif
    if (failedSamples == 1 || failedSamples % 60 == 0) {
      logf("[t=%lu] gauge read failed (x%u): soc %u, %umV", millis(), failedSamples, bd.stateOfCharge, bd.voltage);
    }
    if (failedSamples == kFailedSamplesBeforeUnknown) {
      bd = {0};
      bd.sampled = true;
#if HARDWARE_VERSION >= 7
      bd.presence = batteryPresence.current();
#endif
      return true;
    }
    return false;
  }
  if (failedSamples) {
    logf("[t=%lu] gauge reads recovered after %u failed samples", millis(), failedSamples);
    failedSamples = 0;
  }
  bool thermalPause = thermalChargeGuard.update(bd);
#if SOFTWARE_CHARGE_LIMITER
  chargeController.update(bd, thermalPause);
  bd.print(lastBatterySenseMV);
#else
  setChargerEnabled(!thermalPause);
  lastPolledMV = LowBatteryMonitor::plausibleVoltage(bd.voltage) ? bd.voltage : 0;
  bd.print();
#endif
  return true;
}
#endif // HARDWARE_VERSION >= 5


uint8_t chargingPatternCheck(PatternRunner &runner, PowerManager &runState) {
  const int kChargePatternOverlayDuration = 1500; // how long to show charge pattern as an overlay while running main patterns
  const int kChargeRingIdleDuration = 6000;       // how long the transient ring shows while idle (not running patterns)
  const int kFadeTime = 300;
  const int kSitTimeAtFullCharge = 5000;
  const int kRecentStateChangeDelay = 200;
  
  // logf("isCharging=%i, isHexaRunning=%i, hasPattern = %i, lastReachedFullCharge= %i, lastChargingStateChange= %i, millis=%i", 
  //   runState.isCharging(), runState.isRunning(), (bool)(runner.pattern), runState.lastReachedFullCharge(), runState.lastChargingStateChange(), millis());

  uint8_t chargeAlpha = 0;

  // No gaugingReady() check here: the overlay is edge-triggered off lastChargingStateChange(), and
  // PowerManager::update() already withholds that edge until the gauge is readable.
  if (runState.isRunning() && runState.lastRunStateChange() > runState.lastChargingStateChange()) {
    // do not show the charging ui if we powered on right after plugging in
    return 0;
  }
  if (runState.isCharging()) {
    unsigned long lastReachedFullCharge = runState.lastReachedFullCharge();
    // transient ring: time since the last reason to show it (plugged in, turned off while plugged in)
    unsigned long ringWake = runState.lastChargingStateChange();
    if (!runState.isRunning()) {
      ringWake = max(ringWake, runState.lastRunStateChange());
    }
    bool ringExpired = !runState.isRunning() && millis() - ringWake > (unsigned long)kChargeRingIdleDuration;
    if (runner.pattern) {
      int runTime = runner.pattern->runTime();
      if (runState.isRunning() && runTime > kChargePatternOverlayDuration) {
        // fade down overlay while device on
        chargeAlpha = max(0L, 0xFF - 0xFF * (long)(millis() - max(runState.lastRunStateChange(), runState.lastChargingStateChange())) / kFadeTime);
        logdf("fade down overlay device on => %i", chargeAlpha);

      } else if (lastReachedFullCharge && millis() - lastReachedFullCharge > kSitTimeAtFullCharge && runTime > kChargePatternOverlayDuration) {
        // fade down charging ui when fully charged
        int fadeProgress = min(millis() - lastReachedFullCharge - kSitTimeAtFullCharge, runTime - kChargePatternOverlayDuration);
        chargeAlpha = constrain(0xFF - 0xFF * (long)(fadeProgress) / kFadeTime, 0, 0xFF);
        logdf("fade down fully charged => %i", chargeAlpha);

      } else if (ringExpired) {
        // transient ring: shown long enough, fade out; the pixel rail switches off once the panel is black
        chargeAlpha = constrain(0xFF - 0xFF * (long)(millis() - ringWake - kChargeRingIdleDuration) / kFadeTime, 0, 0xFF);
        logdf("fade down transient ring => %i", chargeAlpha);

      } else if (runTime < kFadeTime) {
        // fade up overlay
        chargeAlpha = min(0xFFL, (long)0xFF * runTime / kFadeTime);
        logdf("fade up overlay => %i", chargeAlpha);
      } else {
        // run overlay
        chargeAlpha = 0xFF;
      }
    } else if (!ringExpired && (
              (!runState.isRunning() && lastReachedFullCharge == 0) // not running, not fully charged
            ||  millis() - runState.lastChargingStateChange() < kRecentStateChangeDelay  // just plugged in
            || (millis() - runState.lastRunStateChange() < kRecentStateChangeDelay && lastReachedFullCharge == 0) // just turned off while plugged in
              )) {
      // start overlay
      chargeAlpha = 0x1;
      logdf("start overlay => %i", chargeAlpha);
    }
  } else {
    if (runner.pattern) {
      // fadedown overlay due to not charging
      chargeAlpha = max(0L, 0xFF - 0xFF * (long)(millis() - runState.lastChargingStateChange()) / kFadeTime);
      logdf("fade down overlay not charging => %i", chargeAlpha);
    }
  }
  // if (chargeAlpha) {
  //   logf("  charge overlay alpha = %02X", chargeAlpha);
  // }
  return chargeAlpha;
}

#if HARDWARE_VERSION >= 4
void powerOff() {
  gpio_put(EN_LDO_PIN, false);
  // should power off here, but delay here rather than forever loop, since sometimes we don't.
  while (digitalRead(BUTTON_0) == BUTTON_PRESSED_STATE) {
    // handle the button being left pressed after power off
    delay(50);
  }
  // should lose power here, but don't infinite loop in case we don't
  delay(500);
}
#endif

#endif
