starduststorm/motionhexa/src/ledgraph.h

#ifndef LEDGRAPH_H
#define LEDGRAPH_H

using namespace std;

#include <vector>
#include <algorithm>
#include <FastLED.h>
#include <set>
#include <util.h>
#include <optional>

#include <drawing.h>

#if MINI_VERSION == 1
#define LED_COUNT (91)
#elif MINI_VERSION == 2
#define LED_COUNT (127)
#else
#define LED_COUNT (271)
#endif

#include <mapping.h>
#include "hexaphysics.h"
#include "MotionManager.h"

typedef enum : uint8_t {
  none              = 0,
  clockwise         = 1 << 0,
  counterclockwise  = 1 << 1,
  geometric         = 1 << 2,
  inbound           = 1 << 3,
  outbound          = 1 << 4,
  all               = 0xFF,
} EdgeType;

Graph ledgraph;
constexpr uint16_t kHexaCenterIndex = LED_COUNT/2;
constexpr uint8_t kMeridian = (3 + sqrt(12*LED_COUNT-3))/6 * 2 - 1; // 19
constexpr float pixelSpacing = 3.9;

// serpentine rows on hexa v1-v6 (and mini v1); hexa v7 and mini v2 are row-major
constexpr bool kZigZagPixelWiring = (HARDWARE_VERSION > 0 && HARDWARE_VERSION < 7) || (MINI_VERSION == 1);

// Motion sensor and magnetometer placement
#if HARDWARE_VERSION >= 7
const MotionSensorPlacement kHexaMotionPlacement = {
  .accelGyro = AxisRotation::axes(-Axis::Y, -Axis::X, -Axis::Z),
  // mag z points down in the northern hemisphere
  // Net: a reflection of the accel-style map, consistent with Memsic drawing +Z into the package.
  .mag = AxisRotation::axes(Axis::Y, Axis::X, Axis::Z).rotatedAboutZ(60),
  .position = UMPoint::fromMM(2.449, 17.808),
  .magPosition = UMPoint::fromMM(18.644, 32.191), // v7
  .magTempSlopeUTperC = {0.81f, -0.81f, 4.65f}, // bench on v7. FIXME: test multiple units to confirm; re-check on v8, the mag moved 0.54mm
  .magTempRefC = 40,
};
const UMPoint kHexaV8MagPosition = UMPoint::fromMM(18.376, 31.727);
#else
const MotionSensorPlacement kHexaMotionPlacement = {
  .accelGyro = AxisRotation::axes(Axis::Y, Axis::X, -Axis::Z),
  .mag = AxisRotation::axes(Axis::Y, Axis::X, -Axis::Z),
  .position = UMPoint::fromMM(100-83.125922, 100-92.920152),
};
#endif

HexGrid<PixelIndex> hexGrid(kMeridian, pixelSpacing, kZigZagPixelWiring);

// clockwise degrees, for integer math
static int angleForDirection(HexagonBounding dir) {
  switch (dir) {
  case HexagonBounding::right:     return 0; break;
  case HexagonBounding::downright: return 1*360/6; break;
  case HexagonBounding::downleft:  return 2*360/6; break;
  case HexagonBounding::left:    return 3*360/6; break;
  case HexagonBounding::upleft:   return 4*360/6; break;
  case HexagonBounding::upright:  return 5*360/6; break;
  default:
    assert(false, "angleForDirection");
    return 0; break;
  }
}

static HexagonBounding directionForAngle(int angle) {
  angle = mod_wrap(angle, 360);
  switch (angle) {
    case 0:     return HexagonBounding::right; break;
    case 1*360/6: return HexagonBounding::downright; break;
    case 2*360/6: return HexagonBounding::downleft; break;
    case 3*360/6: return HexagonBounding::left; break;
    case 4*360/6: return HexagonBounding::upleft; break;
    case 5*360/6: return HexagonBounding::upright; break;
  default:
    assert(false, "directionForAngle(%i)", angle);
    return HexagonBounding::interior; break;
  }
}

struct fAxial;
template<typename T>
struct AxialT : vectorT<T> {
  AxialT() : vectorT<T>(0,0,0) {}
  AxialT(T q, T r) : vectorT<T>(q,r,-q-r) {}
template<typename T2>
  AxialT(vectorT<T2> v) : AxialT((T)v.x,(T)v.y) {}
  AxialT(fAxial fax);
  T q() { return this->x; };
  T r() { return this->y; };
  T s() { return this->z; };
  void setQR(T q, T r) {
    this->x = q;
    this->y = r;
    this->z = -q - r;
  }
};

using Axial = AxialT<int16_t>;

struct fAxial : vectorT<float> {
  fAxial() : vectorT<float>(0,0,0) {}
  fAxial(Axial ax) : vectorT<float>(ax.q(),ax.r(), ax.s()) {}
  fAxial(float q, float r) : vectorT<float>(q,r,-q-r) {}
  float q() { return x; };
  float r() { return y; };
  float s() { return z; };
  void setQR(float q, float r) {
    x = q;
    y = r;
    z = -q - r;
  }
  Axial cubeRound() {
    int qi = round(q());
    int ri = round(r());
    int si = round(s());

    float q_diff = fabs(qi - q());
    float r_diff = fabs(ri - r());
    float s_diff = fabs(si - s());

    if (q_diff > r_diff && q_diff > s_diff) {
      qi = -ri-si;
    } else if (r_diff > s_diff) {
      ri = -qi-si;
    } else {
      si = -qi-ri;
    }
    return Axial(qi, ri);
  }
};

template<typename T>
AxialT<T>::AxialT(fAxial fax) : AxialT((T)fax.q(), (T)fax.r()) {}

class AxialAccess {
  int meridian;
  bool zigzag;
  // axial coordinates are stored in a meridian*meridian 2d array
  std::optional<PixelIndex> *storageToPixelMap; // storage index -> pixel index
  int16_t *pixelToStorageMap; // pixel index -> storage index
  unsigned int index(int q, int r) { // q,r -> storage index
    return (q+meridian/2) + meridian*(r+meridian/2);
  }
public:
  AxialAccess(int meridian, bool zigzag=true) : meridian(meridian), zigzag(zigzag) {
    int n = meridian / 2;
    int count = 3*n*n + 3*n + 1;
    storageToPixelMap = (std::optional<PixelIndex> *)malloc(meridian * meridian * sizeof(std::optional<PixelIndex>));
    memset(storageToPixelMap, 0, meridian*meridian*sizeof(std::optional<PixelIndex>));
    pixelToStorageMap = (int16_t*)malloc(count * sizeof(int16_t));
    memset(pixelToStorageMap, 0xFF, count*sizeof(int16_t));

    // hexa wiring starts top-left going left-to-right; zig-zag (v1-6) alternates direction each row, row-major (v7+) does not
    PixelIndex px = 0;
    for (int r = -n; r <= n; ++r) {
      int q_start = max(-n, -n - r);
      int q_end   = min( n,  n - r);
      int row = r + n;
      bool rightToLeft = zigzag && (row % 2);
      if (rightToLeft) {
        for (int q = q_end; q >= q_start; --q) {
          int idx = index(q, r);
          storageToPixelMap[idx] = px;
          pixelToStorageMap[px] = idx;
          px++;
        }
      } else {
        for (int q = q_start; q <= q_end; ++q) {
          int idx = index(q, r);
          storageToPixelMap[idx] = px;
          pixelToStorageMap[px] = idx;
          px++;
        }
      }
    }
  }
  ~AxialAccess() {
    free(storageToPixelMap);
    free(pixelToStorageMap);
  }

  Axial axialFromPixelIndex(PixelIndex pxIndex) {
    int rectIndex = pixelToStorageMap[pxIndex];
    int q = rectIndex % meridian - meridian/2;
    int r = rectIndex / meridian - meridian/2;
    return Axial(q,r);
  }

  vectorf rectFromPixelIndex(PixelIndex pxIndex) {
    Axial ax = axialFromPixelIndex(pxIndex);
    vectorf rect = hexToRect(ax, 1);
    return rect;
  }
  
  std::optional<PixelIndex> indexAtAxial(int q, int r) {
    if (abs(r) > meridian/2 || abs(q) > meridian/2) {
      return nullopt;
    }
    int rectIndex = index(q,r);
    return storageToPixelMap[rectIndex];
  }
  std::optional<PixelIndex> indexAtAxial(Axial ax) {
    return indexAtAxial(ax.q(), ax.r());
  }
  std::optional<PixelIndex> indexAtRect(vectorf point) {
    fAxial ax = rectToHex(point, 1.0);
    return indexAtAxial(ax);
  }

  vectorf hexToRect(fAxial ax, float size = kMeridian) {
    float x =  size * (ax.q() + 0.5 * ax.r());
    float y = -size * kSqrtThreeOverThree * 3/2.f * ax.r();
    return vectorf(x, y);
  }

  fAxial rectToHex(vectorT<float> point, float size = kMeridian) {
    float x =  point.x / size;
    float y = -point.y / size;
    float q = 1 * x - kSqrtThreeOverThree * y;
    float r = 2 * kSqrtThreeOverThree * y;
    return fAxial(q, r);
  }
};

AxialAccess axial(kMeridian, kZigZagPixelWiring);

void initLEDGraph() {
  assert(hexGrid.valueCount() == LED_COUNT, "led count issue");
  ledgraph = Graph({}, LED_COUNT);
  ledgraph.transposeMap = {
                           {clockwise,counterclockwise}, 
                           {counterclockwise,clockwise}, 
                          };
  // get clockwise/counterclockwise edges by traversing hexgrid starting at px 0 and circling perimeter
  PixelIndex index = 0;
  int angle = 0;
  set<HexGrid<PixelIndex>::HexNode*> found;
  while (index != kHexaCenterIndex) {
    auto node = hexGrid.nodes[index];
    found.insert(node);
    auto nextNode = node->dstForMotion(directionForAngle(angle));
    if (nextNode->isDataNode()) {
      bool alreadyVisited = find(found.begin(), found.end(), nextNode) != found.end();
      if (!alreadyVisited || angle == 300) {
        // discovering a new pixel in the ring, or completing a ring
        PixelIndex nextIndex = nextNode->data();
        ledgraph.addEdge(Edge(index, nextIndex, EdgeType::clockwise));

        if (!alreadyVisited) {
          // not done with ring
          index = nextIndex;
        }
      }
      if (alreadyVisited) {
        // complete loop, turn
        angle = (angle+360/6) % 360;
      }
    } else {
      // edge node, turn
      angle = (angle+360/6) % 360;
    }
  }
};

std::vector<PixelIndex> hexaSide(int side) {
  // u,ur,dr,d,dl,ul order
  constexpr int n = kMeridian / 2; // 9
  static std::vector<PixelIndex> sides[6];
  if (sides[0].empty()) {
    auto perim = ledgraph.bfr(0, EdgeType::clockwise, true);
    for (int s = 0; s < 6; s++) {
      for (int i = 0; i <= n; i++) {
        sides[s].push_back(perim[(s * n + i) % (6 * n)]);
      }
    }
  }
  return sides[side];
}

/* ---------------------------------------------- */

// hex adaptation of Wu's
// FIXME: line endpoints are draw half-lit, so e.g. a polygon will have its vertexes be half lit, which is not great.
static float fpart(float x) {
  return x - floor(x);
}
static float rfpart(float x) {
  return 1 - fpart(x);
}
// The FastLED HD output path applies a gamma 2.8 table to buffer values.
// Wu's coverage split is a fraction of emitted light, so it has to be encoded the same way
static constexpr float kHexlineOutputGamma = 2.8;
static uint8_t coverageToBuffer(float coverage) {
  static uint8_t lut[256];
  static bool built = false;
  if (!built) {
    for (int i = 0; i < 256; ++i) {
      lut[i] = roundf(255.f * powf(i / 255.f, 1.f / kHexlineOutputGamma));
    }
    built = true;
  }
  int i = roundf(constrain(coverage, 0.f, 1.f) * 255.f);
  return lut[i];
}
static void point(PixelStorage<LED_COUNT> &ctx, int q, int r, CRGB color, float coverage, bool useGamma) {
  auto index = axial.indexAtAxial(q, r);
  if (index.has_value()) {
    if (useGamma) {
      color.nscale8_video(coverageToBuffer(coverage));
    } else {
      color.nscale8_video(coverage * 0xFF);
    }
    ctx.point(index.value(), color, blendBrighten);
  }
}
static void hexline(PixelStorage<LED_COUNT> &ctx, float q0, float r0, float q1, float r1, bool useGamma, std::function<CRGB(uint8_t)> colorFunc) {
  CRGB color0 = colorFunc(0);
  CRGB color1 = colorFunc(0xFF);
  
  float s0 = -q0-r0;
  float s1 = -q1-r1;
  // determine axis of iteration (steep)
  float qdiff = fabs(q1 - q0);
  float rdiff = fabs(r1 - r0);
  float sdiff = fabs(s1 - s0);
  bool qline = qdiff >= rdiff && qdiff >= sdiff;
  bool rline = rdiff > qdiff && rdiff >= sdiff;
  bool sline = sdiff > qdiff && sdiff > rdiff;

  bool swapped = false;
  // flip draw direction upwards to halve cases
  if ((qline && q0 > q1) || (rline && r0 > r1) || (sline && s0 > s1)) {
    swapped = true;
    std::swap(q0, q1);
    std::swap(r0, r1);
    std::swap(s0, s1);
    std::swap(color0, color1);
  }

  // we consider the three cubic line directions separately but inline them this way
  if (sline) {
    std::swap(q0,s0);
    std::swap(q1,s1);
  } else if (rline) {
    std::swap(q0,r0);
    std::swap(q1,r1);
  }

  float dq = q1 - q0;
  float dr = r1 - r0;
  float ds = s1 - s0;

  float gradient = (dq == 0.0 ? 1.0 : dr/dq);

  // handle first endpoint
  float qend = roundf(q0);
  float rend = r0 + gradient * (qend - q0);
  float qgap = rfpart(q0 + 0.5);
  float qpxl0 = qend; // this will be used in the main loop
  float rpxl0 = floorf(rend);
  if (sline) {
    point(ctx, -qpxl0-rpxl0, rpxl0,   color0, rfpart(rend) * qgap, useGamma);
    point(ctx, -qpxl0-(rpxl0+1), rpxl0+1, color0,  fpart(rend) * qgap, useGamma);
  } else if (rline) {
    point(ctx, rpxl0,   qpxl0, color0, rfpart(rend) * qgap, useGamma);
    point(ctx, rpxl0+1, qpxl0, color0,  fpart(rend) * qgap, useGamma);
  } else {
    point(ctx, qpxl0, rpxl0  , color0, rfpart(rend) * qgap, useGamma);
    point(ctx, qpxl0, rpxl0+1, color0,  fpart(rend) * qgap, useGamma);
  }

  float rinter = rend + gradient; // first r-intersection for the main loop

  // handle second endpoint
  qend = roundf(q1);
  rend = r1 + gradient * (qend - q1);
  qgap = fpart(q1 + 0.5);
  float qpxl1 = qend; //this will be used in the main loop
  float rpxl1 = floorf(rend);
  if (sline) {
    point(ctx, -qpxl1-rpxl1,     rpxl1,   color1, rfpart(rend) * qgap, useGamma);
    point(ctx, -qpxl1-(rpxl1+1), rpxl1+1, color1,  fpart(rend) * qgap, useGamma);
  } else if (rline) {
    point(ctx, rpxl1,   qpxl1, color1, rfpart(rend) * qgap, useGamma);
    point(ctx, rpxl1+1, qpxl1, color1,  fpart(rend) * qgap, useGamma);
  } else {
    point(ctx, qpxl1, rpxl1,   color1, rfpart(rend) * qgap, useGamma);
    point(ctx, qpxl1, rpxl1+1, color1,  fpart(rend) * qgap, useGamma);
  }

  // main loop
  for (float q = qpxl0 + 1; q <= qpxl1 - 1; ++q) {
    uint8_t progress = 0xFF * (uint8_t)(q-(qpxl0 + 1)) / (uint8_t)(qpxl1 - 1-(qpxl0 + 1));
    if (swapped) progress = 0xFF - progress;
    CRGB color = colorFunc(progress);
    if (sline) {
      point(ctx, -q-floorf(rinter), floorf(rinter),   color, rfpart(rinter), useGamma);
      point(ctx, -q-(floorf(rinter)+1), floorf(rinter)+1, color,  fpart(rinter), useGamma);
    } else if (rline) {
      point(ctx, floorf(rinter),   q,   color, rfpart(rinter), useGamma);
      point(ctx, floorf(rinter)+1, q, color,  fpart(rinter), useGamma);
    } else {
      point(ctx, q, floorf(rinter),   color, rfpart(rinter), useGamma);
      point(ctx, q, floorf(rinter)+1, color,  fpart(rinter), useGamma);
    }
    rinter = rinter + gradient;
  }
}

void hexline(PixelStorage<LED_COUNT> &ctx, fAxial p0, fAxial p1, bool useGamma, std::function<CRGB(uint8_t)> colorFunc) {
  hexline(ctx, p0.q(), p0.r(), p1.q(), p1.r(), useGamma, colorFunc);
}
void hexline(PixelStorage<LED_COUNT> &ctx, fAxial p0, fAxial p1, bool useGamma, CRGB color) {
  hexline(ctx, p0, p1, useGamma, [color] (uint8_t progress) {
    return color;
  });
}

// Antialiased dot at a continuous position in rect space using a 3x3 axial neighborhood
static void hexdot(PixelStorage<LED_COUNT> &ctx, vectorf p, bool useGamma, CRGB color) {
  fAxial c = axial.rectToHex(p, 1.0);
  int q0 = roundf(c.q()), r0 = roundf(c.r());
  for (int q = q0 - 1; q <= q0 + 1; ++q) {
    for (int r = r0 - 1; r <= r0 + 1; ++r) {
      vectorf cc = axial.hexToRect(fAxial(q, r), 1.0);
      float coverage = 1.f - hypotf(cc.x - p.x, cc.y - p.y);
      if (coverage > 0) {
        point(ctx, q, r, color, coverage, useGamma);
      }
    }
  }
}

// insetEdgeNodesBy is here due to dedependency cycle. Axial should have been the base and hexgrid should have been based on that.
// inset the given hexgrid by inset, maintaining pixel index correctness
template<typename T>
void HexGrid<T>::insetEdgeNodesBy(unsigned inset, AxialAccess &axial) {
  assert(inset < meridian/2, "inset too large");
  Axial centerAxial = axial.axialFromPixelIndex(kHexaCenterIndex);
  for (int i = 0; i < nodes.size(); ++i) {
    HexNode *oldNode = nodes[i];
    if (oldNode->isDataNode()) {
      Axial ax = axial.axialFromPixelIndex(i);
      if (ax.q() == 0 && ax.r() == 0) { continue; }
      int distance = max(max(abs(centerAxial.q() - ax.q()), abs(centerAxial.r() - ax.r())), abs(centerAxial.s() - ax.s()));
      if (distance == meridian/2-inset+1) {
        // found the ring where the new edges will go
        // we'll traverse outward until we find the appropriate edge node to copy
        HexNode *edgeNode = NULL;
        Axial unitDirection(sgn(ax.q()), sgn(ax.r()));
        // neighbor ordering is 0:ul, 1:ur, 2:r, 3:dr, 4:dl, 5:l
        // this is grody
        const int neighborDirections[][3] = {{0/*ul*/, 5/*l*/, 4/*dl*/}, {0/*ul*/, -1, 3/*dr*/}, {1/*ur*/, 2/*r*/, 3/*dr*/}};
        int nd = neighborDirections[unitDirection.q()+1][unitDirection.r()+1];
        HexNode *nextNode = oldNode;
        while (edgeNode == NULL) {
          nextNode = nextNode->neighbors[nd];
          if (nextNode->isEdgeNode()) {
            edgeNode = nextNode;
          }
        }
        // we should now have the appropriate edge node to put in place
        nodes[i] = new HexNode(*edgeNode);
        for (int n = 0; n < 6; ++n) {
          HexNode *neighborNode = oldNode->neighbors[n];
          if (neighborNode->isDataNode()) {
            neighborNode->neighbors[(n+3)%6] = nodes[i];
          }
        }
        delete oldNode;
      }
    }
  }
  meridian -= inset*2;
}

#endif
