starduststorm/motionhexa/(commit log)

2024-01-22 concept for a dense hexagonal pixel layout without zig-zag wiring
    [motionhexa.kicad_pcb, motionhexa.kicad_sch, pixels.kicad_sch]
2024-01-30 rename board to hexa, gonna merge some project structure
    [motionhexa.kicad_pcb, motionhexa.kicad_sch, pixels.kicad_sch]
2024-01-30 checkpoint - hexa design at a size to host two control boards; add board with an rp2040 and a 9dof imu; add a wip for a second board prototype using a BQ25895M to drive higher currents and charge par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
    [lipo_parallel.kicad_pcb, lipo_parallel.kicad_sch, motionhexa.kicad_pcb, motionhexa.kicad_sch, rpmotion.kicad_pcb, rpmotion.kicad_sch]
2024-02-01 first successful layout of lipo board; hard power switch only switches 300mA? maybe enough for this project and I can bridge it to stress test
    [lipo_parallel.kicad_pcb, lipo_parallel.kicad_sch]
2024-02-01 minor changes
    [lipo_parallel.kicad_pcb, lipo_parallel.kicad_sch]
2024-02-02 layout/zones improvements to rpmotion; pin-matching plan for multiple boards
    [lipo_parallel.kicad_pcb, lipo_parallel.kicad_sch, motionhexa.kicad_pcb, motionhexa.kicad_sch, rpmotion.kicad_pcb, rpmotion.kicad_sch]
2024-02-02 concept of running rpmotion from SYS line on lipo_parallel so we can still control OTG in software
    [lipo_parallel.kicad_pcb, lipo_parallel.kicad_sch, motionhexa.kicad_pcb, motionhexa.kicad_sch, rpmotion.kicad_pcb, rpmotion.kicad_sch]
2024-02-02 flip direction of pixel data flow and redo all the traces; improvements to layout script including using TraceBuilder for gnd and power draws, and a --lock cli option
    [motionhexa.kicad_pcb, motionhexa.kicad_sch]
2024-02-02 realize I need more space on lipo_parallel to prevent likely emi issues on analog/data lines; this commit is tweaks & comments
    [lipo_parallel.kicad_pcb, lipo_parallel.kicad_sch, motionhexa.kicad_pcb, rpmotion.kicad_pcb]
2024-02-03 make the lipo_parallel pcb taller to fit everything better; lipo_parallel layout concept for battery terminals on the same side - change pin-matchups to work with that better; make motionhexa larger 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
    [lipo_parallel.kicad_pcb, lipo_parallel.kicad_sch, motionhexa.kicad_pcb, motionhexa.kicad_sch, pixels.kicad_sch, rpmotion.kicad_pcb, rpmotion.kicad_sch]
2024-02-03 add caps to schematic and script-wire up the power and gnd for each
    [pixels.kicad_sch]
2024-02-03 first complete wiring
    [lipo_parallel.kicad_pcb, motionhexa.kicad_sch, rpmotion.kicad_pcb]
2024-02-03 ERC fixes
    [lipo_parallel.kicad_sch, motionhexa.kicad_sch, pixels.kicad_sch, rpmotion.kicad_sch]
2024-02-04 fix most DRC issues
    [lipo_parallel.kicad_pcb, lipo_parallel.kicad_sch, pixels.kicad_sch, rpmotion.kicad_pcb]
2024-02-04 layout changes for lipo_parallel to make use of extra space; add some LCSC part numbers
    [lipo_parallel.kicad_pcb, lipo_parallel.kicad_sch]
2024-02-07 fix power routing so that VBUSes are connected across boards, +5v is correctly used for logic-level stepping, and a jumper from VBUS to +5V is available to power pixels if the lipo board is not being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
    [lipo_parallel.kicad_pcb, lipo_parallel.kicad_sch, motionhexa.kicad_sch, rpmotion.kicad_pcb, rpmotion.kicad_sch]
2024-02-07 better routing for rpmotion caps + some gratuitous extra gnd plane
    [rpmotion.kicad_pcb]
2024-02-09 horizontally center sub-board pads
2024-02-09 schematic cleanup from design review
    [lipo_parallel.kicad_pcb, lipo_parallel.kicad_sch, rpmotion.kicad_pcb, rpmotion.kicad_sch]
2024-02-13 swap placement of the rpmotion IMU and level-shifter, I think this improves routing
    [rpmotion.kicad_pcb]
2024-02-14 add a --stats option to layout script that injests trace connections efficiently and computes a few stats; tweaks to rpmotion to fix some minor trace things
    [rpmotion.kicad_pcb]
2024-02-21 fix power path so that VBUSes are connected and rpmotion is powered from 5V in the combined case or a jumper to VBUS in the standalone case; add i2c pullups; add an OTG pullup so OTG is on by default
    [lipo_parallel.kicad_pcb, lipo_parallel.kicad_sch, rpmotion.kicad_pcb, rpmotion.kicad_sch]
2024-02-22 add mount points to motionhexa; add some silkscreen; fix DRC errors
    [lipo_parallel.kicad_pcb, lipo_parallel.kicad_sch, motionhexa.kicad_sch, pixels.kicad_sch, rpmotion.kicad_pcb, rpmotion.kicad_sch]
2024-02-22 add some silk to hexa; fix back attachments should not have paste
2024-02-23 screw point attachments shouold be on soldermask layer
2024-02-23 move vias out of pads, mostly
    [lipo_parallel.kicad_pcb, rpmotion.kicad_pcb]
2024-02-23 lipo_parallel parts selection fixes
    [lipo_parallel.kicad_pcb, lipo_parallel.kicad_sch]
2024-02-28 part selection for a couple resistors
    [rpmotion.kicad_pcb, rpmotion.kicad_sch]
2024-02-28 power switch now controls OTG pin only, expectatio is that power consumption will be low enough with this PP; footprint for new power switch; updates to no longer export OTG pin; export SYS pin inste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
    [lipo_parallel.kicad_pcb, lipo_parallel.kicad_sch, motionhexa.kicad_sch, pixels.kicad_sch]
2024-02-29 add a lil signature
    [lipo_parallel.kicad_pcb, rpmotion.kicad_pcb]
2024-02-29 somehow a part got rotated in schematic
    [rpmotion.kicad_pcb, rpmotion.kicad_sch]
2024-02-29 move attachment points farther out towards the edges so i can fit batteries in the space
    [motionhexa.kicad_sch]
2024-02-29 fix one attachment point position, remove an errant trace
2024-02-29 change resistor for ILIM setting to a nearby value that's in stock at JL
    [lipo_parallel.kicad_pcb, lipo_parallel.kicad_sch]
2024-03-03 improve routing for rp2040 crystal somewhat - closer cap placement and don't route i2c traces under the crystal
    [rpmotion.kicad_pcb]
2024-03-03 make rpmotion board wider at JLC's request to support fabbing the corner castellated holes
    [rpmotion.kicad_pcb]
2024-03-05 rpmotion polish, silkscreen improvements
    [rpmotion.kicad_pcb]
2024-03-05 1u -> 1uF
    [rpmotion.kicad_pcb, rpmotion.kicad_sch]
2024-03-21 lipo_parallel battery terminals polarity was reversed fml
    [lipo_parallel.kicad_pcb, lipo_parallel.kicad_sch]
2024-03-21 backport layout.py changes from spiralears because hexa is a good test case
2024-03-22 bit of relayout for the qspi because i wanted to
    [rpmotion.kicad_pcb, rpmotion.kicad_sch]
2024-03-23 v2 plan: dual-zone 3.3v+1.8v ldo so the rp2040 can have 3.3v for its usb and adc functionality; new qspi flash part that works at 1.8v; add a photoresistor; plenty of relayout; DRC looks good
    [rpmotion.kicad_pcb, rpmotion.kicad_sch]
2024-03-24 SPI SCI/TX pins were swapped in level shifter
    [rpmotion.kicad_pcb, rpmotion.kicad_sch]
2024-03-27 add a microphone to rpmotion bc i can
    [rpmotion.kicad_pcb, rpmotion.kicad_sch]
2024-03-27 export a couple other gpios because i can
    [rpmotion.kicad_pcb, rpmotion.kicad_sch]
2024-03-28 swap in a smd usb port so i don't have to file down the tht pins
    [rpmotion.kicad_pcb, rpmotion.kicad_sch]
2024-03-28 add new usb footprint
2024-03-29 pull rpmotion power in from SYS rather than +5V, because the bq25895m PMID pin (shorted to +5v) is always powered, even if OTG is off, meaning we had no way to power down; this way the rp2040 will al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
    [rpmotion.kicad_pcb, rpmotion.kicad_sch]
2024-03-29 jumper plan - 3 bottom-side jumpers all bridged by default, can cut to set power path
    [rpmotion.kicad_pcb, rpmotion.kicad_sch]
2024-03-29 fix ERC/DRC on rpmotion
    [rpmotion.kicad_pcb, rpmotion.kicad_sch]
2024-03-29 exclude jumpers and pin connectors from bom and pos
    [rpmotion.kicad_pcb, rpmotion.kicad_sch]
2024-03-29 change power switch behavior to switch a mosfet instead of the OTG pin, because the OTG pin does not depower PMID; add more battery terminals because why not
    [lipo_parallel.kicad_pcb, lipo_parallel.kicad_sch]
2024-03-29 switch to a smd usb port in lipo_parallel
    [lipo_parallel.kicad_pcb, lipo_parallel.kicad_sch]
2024-03-29 replace generic PFET symbol with kicad's AO3401A symbol
    [lipo_parallel.kicad_sch]
2024-04-17 minor rpmotion tweaks
    [rpmotion.kicad_pcb]
2024-05-01 add cribbed src; led mapping completed; one decent test pattern; stubs for physics and motion processing
2024-05-03 working single-particle gravity and elastic wall collision
    [MotionManager.h, ledgraph.h, main.cpp, patterns.h]
2024-05-03 pixel collision working and stable, but incorrectly "sticky" like there's a flipped sign somewhere that i can't find bc it's very past 3am rn
    [patterns.h]
2024-05-09 rewrite physics border collision using edge nodes on the hex grid rather than a second hexagonal bounding box
    [MotionManager.h, hexaphysics.h, ledgraph.h, patterns.h]
2024-05-09 fix several pixelphysics issues; looking much better, only a little bit of weirdness left
    [hexaphysics.h, main.cpp, patterns.h]
2024-05-15 fix a bug where particles sometimes get stuck, especially in corners
    [hexaphysics.h]
2024-07-12 make some pattern variations for real world use; switch patterns with button; add a welcome animation; add fading auto-brightness; factor out HexaShells a bit; more work on per-pixel acceleration, wh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
    [MotionManager.h, hexaphysics.h, main.cpp, patterns.h]
2024-07-12 update to kicad 8 format
    [lipo_parallel.kicad_pcb, lipo_parallel.kicad_sch, motionhexa.kicad_sch, pixels.kicad_sch, rpmotion.kicad_pcb, rpmotion.kicad_sch]
2024-08-30 add a z to vectorT so it can be used with agmt; more vectorT operators; get clockwise/counterclockwise edges labeled in hexa and use that to write a gorgeous motion-reactive new pattern aptly called 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
    [hexaphysics.h, ledgraph.h, main.cpp, patterns.h]
2024-12-15 initial commit of merged controller with separated boost and charge functional groups and a move to rp2350; schematic pretty far along, some layout of functional groups coming along; trying out a rec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
    [hexacontroller.kicad_pcb, hexacontroller.kicad_sch]
2024-12-23 concept for sleek hexa-corner controller design
    [hexacontroller.kicad_pcb, hexacontroller.kicad_sch]
2024-12-27 bring over fixed layout script from earrings, with updates to support KiCAD 8 python layer
2025-01-06 more kicad8 fixes to layout script; plus remove footprintConnectedItems when adding a duplicate footprint
2025-01-06 add pads for new hexa controller and add to hexa with fresh layout; todo proper routing around the new controller footprint
    [hexacontroller.kicad_pcb, hexacontroller.kicad_sch, motionhexa.kicad_sch, pixels.kicad_sch]
2025-01-09 hexacontroller ERC & DRC, layout tweaks
    [hexacontroller.kicad_pcb, hexacontroller.kicad_sch]
2025-01-09 update hexa pixelboard to route properly with new controller; decorate it differently
    [hexacontroller.kicad_pcb]
2025-01-09 zone fill fixes, minor routing tweaks, silkscreen edits
    [hexacontroller.kicad_pcb]
2025-01-09 schematic tweaks and part number specification; some footprint clarification; drc fixes
    [hexacontroller.kicad_pcb, hexacontroller.kicad_sch]
2025-01-09 changed some vias drill sizes to standardized on 0.4mm and reduce different drill sizes needed; add a couple gpio outs that can be used for spi, i2c, uart or gpio; add some silkscreen labels
    [hexacontroller.kicad_pcb, hexacontroller.kicad_sch]
2025-01-10 where is it tho
    [hexacontroller.kicad_pcb]
2025-01-10 exclude pin sockets from position files
    [hexacontroller.kicad_pcb]
2025-01-10 parts selection; tweak FOC to 90mA since 22.5k resistors are not in stock at all
    [hexacontroller.kicad_pcb, hexacontroller.kicad_sch]
2025-01-30 switch back to rp2040
    [hexacontroller.kicad_pcb, hexacontroller.kicad_sch]
2025-02-02 fix the pixels mosfet pin order to correctly match the part we're going to use
    [hexacontroller.kicad_pcb, hexacontroller.kicad_sch]
2025-02-02 make hexa capacitors 10u instead of 1u. I would have sworn this is how they were already, but nope. first run used 1u.
    [pixels.kicad_sch]
2025-02-02 silkscreen fixes and refill zones
    [hexacontroller.kicad_pcb]
2025-02-03 shorten the long-side controller edges slightly to give more room for castellated soldering; just make all the extra pins GND; schematic tidy; lots of trace&zone size/position tweaks; isolate In1.Cu 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
    [hexacontroller.kicad_pcb, hexacontroller.kicad_sch]
2025-02-05 change microphone cap to 1u; specify some cap part nums; trace/zone tweaks
    [hexacontroller.kicad_pcb, hexacontroller.kicad_sch]
2025-02-05 specify 100nF part numbers
    [hexacontroller.kicad_pcb, hexacontroller.kicad_sch]
2025-02-05 change button part bc my favorite button is out of stock - means switching USBBOOT back to a jumper; swap crystal caps for ones that are in stock
    [hexacontroller.kicad_pcb, hexacontroller.kicad_sch]
2025-02-05 fix a couple pin labels; remove the button reference designator; scoot pin labels on hexa
    [hexacontroller.kicad_pcb]
2025-02-13 annotate microphone port with a circle
    [hexacontroller.kicad_pcb]
2025-03-24 offload motion data fetch to core1 because it was slow; this boosts framerates by 50-60% (!!) and meant that physics was now running far too fast, so also fix that so that it's more framerate invaria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
    [MotionManager.h, hexaphysics.h, ledgraph.h, main.cpp, patterns.h]
2025-04-03 note the correct battery I'm using in the pcb file; fix schematic note about ADC battery level reads
    [hexacontroller.kicad_pcb, hexacontroller.kicad_sch]
2025-06-24 improve welcome animation to remove idle frames at the end; add an intro animation to MotionHexa pattern that i will probably later generalize; disable gryo in physics for now
2025-06-30 merge v3 hardware into main
    Squashed commit of the following:
    commit b8620bfff064c6ee577bc1d40fecacf3ba7f2be5
    Author: Opal Holley <lumin@escent.email>
    Date: Sat Jun 21 11:23:50 2025 -0700
    move mic pin 1 marker since we moved pin 1
    commit bcd9edf40e51f245d24b0234ee5572b14d47c208
    Author: Opal Holley <lumin@escent.email>
    Date: Sat Jun 21 11:15:08 2025 -0700
    rotate design back to neutral position; fix some DRC
    commit caea33f372b51391b79c2b7f89a8ac51180d4fc8
    Author: Opal Holley <lumin@escent.email>
    Date: Fri Jun 20 23:46:37 2025 -0700
    fix microphone footprint was mirrored, probably since I looked at the upside-down part in the datasheet; caught in DFM
    commit 8c1afc7f6e7d9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
    [hexacontroller.kicad_pcb, hexacontroller.kicad_sch, motionhexa.kicad_pcb, motionhexa.kicad_sch]
2025-07-01 add datasheet to mosfet
    [hexacontroller.kicad_pcb, hexacontroller.kicad_sch]
2025-07-17 hardware v3 bringup: charging indicator UI! somewhat clunky but working pretty well; fetching battery data on core1 using edrean/BQ27427; power switch read requires patched Q1 P-mosfet
2025-07-24 fix several charging UI issues but find several more
    [main.cpp, patterns.h]
2025-08-07 ledgraph.h tab size 4 -> 2
2025-08-12 schematic concept for powering hexa up using a pushbutton instead of a power switch, though leave the switch in place for now; first pass at a complete layout; needs review
    [hexacontroller.kicad_pcb, hexacontroller.kicad_sch]
2025-08-14 schematic comments; add battery sense back to aid battery detection; move mcu gpio pins around for layout; many layout tweaks
    [hexacontroller.kicad_pcb, hexacontroller.kicad_sch]
2025-08-14 zone tweaks; fix ERC and DRC issues
    [hexacontroller.kicad_pcb, hexacontroller.kicad_sch]
2025-08-15 swap diode parts for parts that are in stock, plus a higher current diode for the two that need it
    [hexacontroller.kicad_pcb, hexacontroller.kicad_sch]
2025-08-15 swap the +5V load switch cap to a 10u 0603 to help manage inrush; move main button even closer to board center and re layout
    [hexacontroller.kicad_pcb, hexacontroller.kicad_sch]
2025-08-15 zone fill?
    [hexacontroller.kicad_pcb]
2025-08-27 schematic comments
    [hexacontroller.kicad_sch]
2025-08-29 v4 bringup & button-based power-on-off (debug code still messy with v3 power switch woes and v4 investigation); add a clunky power-off animation; move pins into pinout.h; stop initing spi bc FastLED 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
2025-08-29 improve AxialAccess and add an Axial type for holding an address; some improvements to vectorT to support this; do HexGrid connections on init to remove a FIXME; remove old EdgeType::geometric nonsen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
    [hexaphysics.h, ledgraph.h, main.cpp, patterns.h]
2025-08-30 v5! USB CC lines were 511K, need to be 5.11K; replace thermistor in lipo charger with basic 10k since it's not measuring battery temp anyway and was disrupting continuous charging; more carefully con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
    [hexacontroller.kicad_pcb, hexacontroller.kicad_sch]
2025-08-30 pull the power switch off entirely; relayout a little
    [hexacontroller.kicad_pcb, hexacontroller.kicad_sch]
2025-09-02 specify 10k R part; slight copper tweaks; DRC
    [hexacontroller.kicad_pcb, hexacontroller.kicad_sch]
2025-09-02 great job kicad, yes 360 == 0
    [hexacontroller.kicad_pcb]
2025-09-03 swap out parts for battery monitor, load switch, dual-zone regulator, and microphone for similar in-stock parts
    [hexacontroller.kicad_pcb, hexacontroller.kicad_sch]
2025-09-03 fix a couple Rs that were labeled as 4.7K but using 2.2K parts; add part #s for a couple more passives
    [hexacontroller.kicad_pcb, hexacontroller.kicad_sch]
2025-09-06 fix a charging pattern animation if charge level goes down; add a different pixelphysics variant
    [patterns.h]
2025-09-09 antialiased line drawing on the hex with an adaptation of Wu; axial <=> rect coorindate translation; things are working just fine when i use floating point, actually; fix power-off when using a test 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
    [ledgraph.h, main.cpp, patterns.h]
2025-09-12 some changes to motion data processing that mostly don't do anything yet - change DMP to use Quat9 for orientation; pull full DMP data frame out of core1; minor tweaks; eventually this supports a wor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
2025-09-13 add a board mod option to replace vias with a drawn circle
2025-09-14 set battery design capacity in bq27* and tidy main a little bit
2025-09-15 mitigate accidental battery drain by waiting in sleep state if the button is held through reboot; organize power and charging related code somewhat indiscriminately into power.h and roll more state i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
    [main.cpp, power.h]
2025-09-16 correct datasheet
    [hexacontroller.kicad_sch]
2025-09-22 add some disabled code to gather photosensor calibration data; update dustlib
2025-09-22 battery config and detection-at-boot working correctly
    [main.cpp, power.h]
2025-09-22 add a debug pixel for battery success since i've now found two v5 units with physically cracked BQ27421 chips that don't function
    [main.cpp]
2025-09-23 enhance power on/off animations and make power on animation interruptible:)
2025-09-23 actually, fast-path out of the power-on animation earlier and allow the first pattern to play behind it while it finishes
2025-09-24 improve pixelphysics responsiveness by no longer dropping low order bits off the acceleration
    [hexaphysics.h, patterns.h]
2025-09-24 add velocity color to the large bouncy ball since it seems to work better now, outset it by 1
2025-09-24 i didn't want to remove LineTest so i made it into a prideful spinny thing
    [main.cpp, patterns.h]
2025-09-24 replace a right shift with division because these numbers might be negative
    [hexaphysics.h]
2025-09-24 treat 95% charged as 'full' for the purposes of animation
2025-09-25 spinny thing tweak; be less eager about turning off pixels; float optimizations and a fixme for later
    [ledgraph.h, main.cpp, patterns.h]
2025-09-25 fix a physics issue where particles would fail to move to an adjacent space due to overconstraining of particle position; bandaid a physics wall collision issue; make physics debug togglable; fix pow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
    [hexaphysics.h, main.cpp]
2025-09-25 fix an issue where we were showing the charging ring briefly after turning on if hexa was also just plugged in
    [power.h]
2025-09-25 fix showing the power-off animtion twice if you released and then long-pressed again during the power-off animation
    [main.cpp]
2025-09-26 mitigation for a weird vbus issue
    [main.cpp]
2025-09-28 remove rpmotion and lipo_parallel since they have not been relavant since hexa v1
    [lipo_parallel.kicad_pcb, lipo_parallel.kicad_sch, rpmotion.kicad_pcb, rpmotion.kicad_sch]
2025-09-30 add a submodule for a forked copy of the edrean/BQ27427 Battery Fuel Gauge library which has a fix for building against framework-arduinopico
2025-10-01 fix rect<-->hex coordinate translation since it was off by 30 degrees
    [ledgraph.h]
2025-10-25 fix opportunistic autobrightness (which is still disabled)
    [main.cpp]
2025-11-17 audio checkpoint: workaround for unusual PDM microphone timing; include a skeleton of kissfftr; pull in (modified wip) audio class from penta; add some incredible-looking sound-reactive patterns!
    [ledgraph.h, main.cpp, patterns.h, pinout.h]
2025-11-20 tiny animation polish when resuming a canceled power-on animation
2025-11-22 fix FFT spectrum averaging; improve sound auto-gain to scale non-linearly when over- or under-drawing, since linear scaling was inadaquate for very loud environments; add subtle motion responsiveness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
    [patterns.h]
2025-11-22 tweak to reduce flicker on pridefulspinnything; add a fixme about line drawing
    [ledgraph.h, patterns.h]
2025-11-22 always draw when running soundpatterns (fpsassertion) because we're keeping the display on (this was causing things to appear stuck sometimes)
    [main.cpp]
2025-11-27 add an feature to layout.py to rotate a set of footprints by pattern match
2025-12-04 start v6: diode from vbus to lipo charger to prevent what i think is backflow that sometimes keeps vbus powered after unplugging usb; remove boost circuit because it is unnecessary and i haven't bene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
    [hexacontroller.kicad_sch]
2025-12-04 change photosensor read cap 1u=>100n for faster response
    [hexacontroller.kicad_sch]
2025-12-04 bring in controller edges to give more clearance for backcase clips; first pass v6 layout
    [hexacontroller.kicad_pcb, hexacontroller.kicad_sch]
2025-12-04 hexa panel update for smaller controller size
    [motionhexa.kicad_pcb]
2025-12-04 fix a castellated pin that somehow got set to the wrong pin number; minor layout tweaks
    [hexacontroller.kicad_pcb]
2025-12-04 fix an ERC warning
    [hexacontroller.kicad_sch]
2025-12-04 exclude a pin connector from bom
    [hexacontroller.kicad_pcb]
2025-12-04 add url to silk; fix silk pin labels
    [motionhexa.kicad_pcb]
2025-12-04 rotate sk9822 pixel footprint to match the default orientation that JLC uses
    [motionhexa.kicad_pcb]
2025-12-04 exclude a pin connector from bom (schematic)
    [hexacontroller.kicad_sch]
2025-12-04 add a schematic note to mention that v6 had a diode part swap at order time
    [hexacontroller.kicad_sch]
2025-12-13 v6 detector pin
2025-12-13 tweak to fix an issue where we were not drawing the last frame of animation before pixels turn off
    [main.cpp]
2026-03-04 remove AxialAccess dependency on HexGrid - it should generate a map directly from zig-zag wiring
2026-03-04 spice up PulseHexaSmooth with audio-reactive glitch on the "underside" of it
    [ledgraph.h, main.cpp, patterns.h]
2026-03-04 some renaming, templatize line class using ABC for linef support, vector tweaks, plus fix cartesian<->axial conversions hopefully for good
    [hexaphysics.h, ledgraph.h]
2026-03-04 fix rectToHex usages in triangle and spinny; stop bitshifting when i mean multiplication or division; tweaks
    [patterns.h]
2026-03-10 MotionManager gyro and accel fullscale units rationalization; add (working i think) centrifugal force to accelerationAtPixelIndex; dramatically spice up the LargeBouncyBall with improved physics (cen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
    [MotionManager.h, hexaphysics.h, ledgraph.h, main.cpp, patterns.h]
2026-03-10 rectToHex flipped sign, so now yaw needs to be fixed because right now the triangle is not staying put at all.
    [patterns.h]
2026-03-10 spice up TriangleSpin by counterrotating a whole tetrahedron; export quaternions in MotionFrame to do this; fix a rare crash in case of quaternion drift; block comment in prep for rationalizing motio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
    [MotionManager.h, ledgraph.h, patterns.h]
2026-03-10 start consolidating the project-specific motion data mutations (due to chip placement) into ledgraph.h for now. previously they were scattered across a few places. this allows patterns to operate on 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
    [MotionManager.h, hexaphysics.h, ledgraph.h, main.cpp, patterns.h]
2026-03-24 fix and/or work around discontinuity issues in MotionHexa pattern with modulus tweaks (fix) and moving to int32s (makes the problem muuuch less frequent)
    [patterns.h]
2026-04-02 tweak tetrahedron counterrotation and fix color continuity
    [patterns.h]
2026-05-02 project-side workaround for an older build issue that seems to be in framework-arduinopico deprecated-avr-comp/avr/pgmspace.h, where it's included from SparkFun code
2026-05-04 hexacontroller -> kicad9 format
    [hexacontroller.kicad_pcb, hexacontroller.kicad_sch]
2026-05-04 3d model for usb port part
    [hexacontroller.kicad_pcb]
2026-08-17 work around a bad issue with v4-v6 units which apparently had the wrong lipo charging part and were charging to 4.35V - apply a software-limited charging process that charges in bursts, with scaled p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
    [main.cpp, patterns.h, power.h]
2026-08-25 adopt dustlib kicad pixel layout code; fix pixel footprint rotation for updated footprint
2026-08-25 a first pass on v7 unified layout; still to do: replace lipo charger and move back to BQ27427
    [pixels.kicad_sch, unified_pcb.kicad_pcb, unified_pcb.kicad_sch]
2026-08-25 switch to LY4176D charger
    [unified_pcb.kicad_pcb, unified_pcb.kicad_sch]
2026-08-25 phototransistor caps to 470nF for faster sampling
    [unified_pcb.kicad_pcb, unified_pcb.kicad_sch]
2026-08-26 change BQ27421 back to BQ27427
    [pixels.kicad_sch, unified_pcb.kicad_pcb, unified_pcb.kicad_sch]
2026-08-26 add an RS0302 for dual-voltage-zone i2c; sprinkle some RC in various places for good measure; lots of layout improvements
    [unified_pcb.kicad_pcb, unified_pcb.kicad_sch]
2026-08-26 move phototransistor RC load closer to mcu for better signal; use concentric 1v1 and 3v3 plane under rp2350 per typical by finding places for vias; lots of layout tweaks
    [unified_pcb.kicad_pcb]
2026-08-26 alignment guide and no-part smd pads out of bom and pos
    [unified_pcb.kicad_pcb]
2026-08-26 wow ICM_20948 is moving out of production and is expensive - move to BMI270+MMC5603NJ, no need anymore for 1.8V net at all remove old schematic pieces, update schematic format mag layout fix crystal 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
    [pixels.kicad_sch, unified_pcb.kicad_pcb, unified_pcb.kicad_sch]
2026-08-26 magnetic sensor layout in a little corner of the board hopefully well isolated some shorter routing for long-path edge cases due to gnd and pixel/vdd plane slicing
    [unified_pcb.kicad_pcb, unified_pcb.kicad_sch]
2026-08-26 note about part replacement on v7 order
    [unified_pcb.kicad_sch]
2026-08-31 batsys ->| vbus gets a mosfet for battery efficiency; switch from rp2350 to rp2354 since qspi memory chip is low stock and this is cheaper anyway; bom replacements for diodes and passives for out of 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
    [unified_pcb.kicad_pcb, unified_pcb.kicad_sch]
2026-09-02 move capacitors away from board corners for case-clearance good measure; scoot mag up a bit for same reason
    [unified_pcb.kicad_pcb]
2026-09-03 remove the not-working version of multi-sensor autobrightness that got into main
    [unified_pcb.kicad_pcb]
2026-09-03 move vias with drills that are partially clipping pads into better locations to try and reduce solder flow errata
    [unified_pcb.kicad_pcb]
2026-09-12 fix/workaround: an issue where we use digitalRead before pinMode on main button and this fails on rp2350; an issue where we read charge current and other values negative on BQ27427 due to device bug;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
    [main.cpp, power.h]
2026-09-13 gamma-correct the Wu's antialiased line draw to fix a flicker in PridefulSpinnyThing's axial alignment; make it optional so TriangleSpin can opt out
    [ledgraph.h, patterns.h]
2026-09-17 compass (with elaborate auto-calibration) seems to be working! todo: run multiple units to get a good hardcoded calibration baseline
2026-09-21 on-device hwtest path; low-battery detector; fix/workaround for a GPOUT pullup being to the wrong line so disabling sleep on the bq mitigates
    [bench.h, hwtest.h, main.cpp, power.h]
2026-09-24 fix MotionHexa using a bad baseline constant and so moving underwhelmingly slowly; fix motionhexa continuity bugs hopefully once and for all with an lcm modulus motionintegrator
    [patterns.h]
2026-09-24 v8 hw detection in sw; fix (unused) mag position in v8
    [MotionManager.h, bench.h, hwdetect.h, ledgraph.h, main.cpp]
2026-09-25 hwtest fixes for mini
    [hwtest.h, main.cpp, pinout.h]
2026-09-25 fix 500ms ticking in motionhexa again
    [patterns.h]
2026-09-26 don't scale charging ring brightness down the line due to not looking great on low autobrightness
2026-09-27 limit charging when device temp > 60Cand make the charging ring transient for 6s instead of persistent during the whole charge (saves a lot of heat). i was seeing units get too hot when several were 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
    [bench.h, main.cpp, power.h]
2026-09-28 remove hexacontroller/ and hexa/ both superceded by unified_pcb
    [hexacontroller.kicad_pcb, hexacontroller.kicad_sch, motionhexa.kicad_pcb, motionhexa.kicad_sch, pixels.kicad_sch]
2026-09-29 case stls and README updates
    [minihexa v2 - diffuser.stl, minihexa v2 - housing.stl, motionhexa backcase v5-6 - 4.2mm button - 0.5-1mm clip.stl, motionhexa backcase v7-8 - 4.3mm button.stl, motionhexa frontcase v5-6.stl, motionhexa frontcase v7-8.stl]
2026-09-29 fix for an issue where switching patterns while hexa is moving quickly sometimes results in a temporarily wrong gravity vector and particles stuck on the ceiling for a few seconds. to fix, we'll run 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
    [MotionManager.h, main.cpp, patterns.h]
